riyadh-gif/solar-tracker-cps-pens/sistem_cps_tracker_pens.pdf

## Solar Tracker Dua Sumbu PENS sebagai Cyber-Physical System

Model Matematis, Validasi Numerik, dan Jalan Menuju Digital Twin

Program Magister Terapan, Politeknik Elektronika Negeri Surabaya Titik pemasangan: −7,276006◦ LS, 112,794327◦ BT

October 21, 2026

Abstract

Dokumen ini memodelkan solar tracker dua sumbu (azimuth dan kemiringan) sebagai Cyber-Physical System, mengikuti kerangka Solar Tracking Systems and Cyber-Physical Systems, tetapi dengan seluruh besaran berasal dari CAD alat, pelat nama komponen, data cuaca terukur, atau simulasi multi-benda yang tervalidasi. Setiap persamaan diberi nama modelnya dan setiap asumsi diberi tanda eksplisit.
Alat yang dimodelkan memakai motor stepper loop tertutup 57HSE1.5N (Th = 1,5 N m) dengan enkoder di poros rotor, dan reduksi gigi 5,0:1 pada sumbu kemiringan (pinion 6 gigi, gigi besar 30, modul 2,75; rasio diukur langsung di alat). Sumbu azimuth tetap penggerak langsung.
Perbedaan dengan kerangka rujukan tetap ada tetapi alasannya bergeser. Kerangka itu mengandaikan servo bertorsi dengan enkoder yang terbaca host. Di sini enkoder ada, tetapi tertutup di dalam driver: host hanya mengirim pulsa langkah dan arah, tidak pernah membaca q, dan tidak dapat memerintahkan torsi sesaat. Karena itu Computed Torque Control dan Sliding Mode Control tetap tidak dapat diterapkan apa adanya, kini karena antarmukanya, bukan karena ketiadaan sensor. Penggantinya adalah umpan maju astronomis, pembentuk perintah input shaper ZVD, dan tapis Kalman diperluas yang menaksir simpangan di sisi beban, yaitu bagian yang justru tidak terlihat oleh enkoder rotor.
Hasil utama: reduksi gigi mengubah anggaran torsi sumbu kemiringan dari 144% (macet) menjadi 24%, dan memperhalus microstep di beban dari 0,1125◦ menjadi 0,0225◦
. Karena
reduksi menaikkan pegas magnet yang dirujuk ke beban melewati kekakuan poros, frekuensi alami kemiringan hanya bergeser 4,3% terhadap seluruh rentang penguatan driver yang belum diketahui, sehingga datasheet yang masih ditunggu praktis hanya memengaruhi azimuth. Tapis Kalman dengan LDR terkalibrasi menurunkan galat pointing dari 2,52◦ menjadi 0,18◦ ;
beban angin terburuk sebelas tahun memakai 9,2% torsi tahan. Panel diparkir datar saat hujan, dan itu terbukti tidak merugikan: pada mendung tebal panel datar justru memanen 102,3% dari panel yang menjejak.

## Daftar Isi

1 Kerangka Koordinat dan Notasi | 4
2 Posisi Matahari dan Irradiance | 4

3 Kinematika | 5
4 Dinamika Multi-Benda | 6
5 Aktuator: Stepper Loop Tertutup dengan Reduksi Gigi | 8
6 Strategi Kontrol | 10
7 Model Listrik Panel Surya | 11
8 Sensor LDR dan Penggabungan Berbobot | 12
9 Beban Angin dari Data Terukur | 14

10 Hujan: Parkir Datar, Kaca Basah, dan Pendinginan | 15
11 Osilasi dan Dampaknya pada Energi | 16
12 Tapis Kalman Diperluas sebagai Penaksir Sisi Beban | 16
13 Arsitektur Cyber-Physical System | 18
14 Lapisan Digital Twin | 19
15 Ringkasan Hasil Terukur | 20
16 Kekurangan dan Parameter yang Masih Diasumsikan | 20

## 1 Kerangka Koordinat dan Notasi

Model: Kerangka toposentrik lokal North-West-Up (NWU)

Kerangka rujukan memakai ENU; dokumen ini memakai NWU karena azimuth kompas kemudian muncul langsung sebagai rotasi negatif terhadap sumbu tegak, tanpa konversi tambahan:

xˆ = Utara, | yˆ = Barat, | zˆ = atas (zenith). | (1)

Sumbu engsel kemiringan searah rel panjang, yaitu sumbu x alat, sehingga panel berguling ke kanan dan kiri, bukan jungkat-jungkit sepanjang rel.

Besaran | Lambang Definisi
Sudut sendi azimuth | q1 | putar terhadap zˆ, positif searah jarum jam dilihat dari
| atas, tanpa batas
Sudut | sendi
kemiringan
q2 | 0 = panel datar; batas ±45◦
| | (ASUMSI)
Arah hadap rel | ψ | ψ = 90◦
(rel menghadap Utara, ASUMSI)
Arah miring kompas | q1 + ψ | arah panel condong, diukur searah jarum jam dari Utara
Azimuth matahari | A | searah jarum jam dari Utara
Elevasi matahari | e | dari horizon; zenith z = 90◦ − e

## 2 Posisi Matahari dan Irradiance

### 2.1 Vektor arah matahari

Model: NREL Solar Position Algorithm (SPA), Reda dan Andreas

Kerangka rujukan memakai rumus deklinasi sederhana sin αs = sin ϕ sin δ + cos ϕ cos δ cos ω. Sistem ini memakai SPA melalui pustaka pvlib, yang memperhitungkan nutasi, aberasi, dan refraksi atmosfer. Vektor satuan menuju matahari:

sˆ =

cos e cos A
− cos e sin A
sin e

- . | (2)

Tervalidasi: selisih terhadap astropy, SolTrack, dan Pysolar di bawah 0,011◦ .

### 2.2 Irradiance langit cerah dan tutupan awan

Model: Langit cerah Ineichen-Perez; Model: Faktor awan Kasten-Czeplak; Model: Dekomposisi Erbs

Irradiance horizontal global pada tutupan awan N okta diperoleh dari nilai langit cerah:

Gh = Gh,cs "
1 − 0,75

N
8

3,4

, | N ∈ [0, 8]. | (3)

Pemisahan komponen langsung (DNI, Ib) dan baur (DHI, Id) memakai korelasi Erbs melalui indeks kecerahan kt = Gh/(I0 cos z).

### 2.3 Irradiance pada bidang panel

Model: Transposisi isotropik Liu-Jordan; Model: Koreksi sudut datang ASHRAE (Souka-Safwat)

Sudut datang θi memenuhi cos θi = sˆ · nˆ. Faktor IAM yang memodelkan pantulan kaca:

Kτ (θi) = 1 − b0

1
cos θi

− 1

, | b0 = 0,05 (ASUMSI). | (4)

Irradiance total pada bidang panel (plane of array, POA):

GPOA = Ib cos θi Kτ
| | {z | }
langsung

+ Id

1 + cos β
2
| | {z | }
baur langit

+ Gh ρg

1 − cos β
2
| | {z | }
pantulan tanah
, | (5)

dengan β kemiringan panel dari horizontal (cos β = nz) dan ρg albedo tanah (0,25 ASUMSI).

Catatan penting. Dua suku terakhir Persamaan (5) menarik titik optimum menjauh dari arah matahari, dan ke arah yang berlawanan satu sama lain. Konsekuensinya dibahas di Bagian 7.

## 3 Kinematika

### 3.1 Vektor normal panel

Model: Kinematika rotasi benda tegar, rantai dua sendi putar
Normal panel diperoleh dengan memutar vektor zenith n0 = [0, 0, 1]T berturut-turut terhadap sumbu engsel kemiringan lalu sumbu azimuth:

nˆ = Rz(−q1) Rx(q2) n0 =

sin q2 cos(q1 + ψ)
− sin q2 sin(q1 + ψ)
cos q2

- . | (6)

Basis panel yang menyertainya, dengan a = q1 + ψ dan b = q2:

xˆp =

cos b cos a
− cos b sin a
− sin b

- (arah chord, melintang engsel), yˆp =

sin a
cos a
0

- (arah span, sejajar engsel).

(7)

Tervalidasi: normal panel dari TF Gazebo berbanding Persamaan (6) pada (q1, q2) = (0, 30◦ ),
(90◦

, 30◦

), (0, −30◦

) menunjukkan selisih 0,14 sampai 0,34◦ , seluruhnya terjelaskan oleh defleksi gravitasi.

### 3.2 Kinematika balik

Untuk matahari pada (A, z) terdapat dua solusi,

(q1, q2) = (A − ψ, z) | atau | (A − ψ + 180◦
, −z), | (8)

dan dipilih cabang yang kontinu terhadap langkah sebelumnya, sehingga melewati zenith tidak menuntut putaran azimuth 180◦

### 3.3 Jacobian dan singularitas keyhole

Model: Jacobian analitik dan dekomposisi nilai singular

Turunan Persamaan (6) terhadap sudut sendi:

∂nˆ
∂q1

= − sin q2 yˆp,

∂nˆ
∂q2
= xˆp, | (9)
sehingga matriks Jacobian J = [ ∂nˆ/∂q1 | ∂nˆ/∂q2 ] ∈ R

3×2 memiliki nilai singular σ1 = 1 dan σ2 = |sin q2|, dengan bilangan kondisi

κ(J) = 1
|sin q2|
. | (10)
q2 | 1
- 5
| ◦ | 30◦ | 45◦
κ(J) 57,3 | 11,5 | 2,0 | 1,4

Inilah efek keyhole, dinyatakan sebagai hilangnya rank, bukan sebagai gejala terpisah. Dampaknya muncul kembali sebagai bobot sensor (Bagian 8) dan sebagai kovarians tapis (Bagian 12), tanpa memerlukan aturan ambang buatan.

### 3.4 Galat pointing dan rugi kosinus

Model: Hukum kosinus Lambert

θerr = arccos(nˆ · sˆ), | rugi relatif komponen langsung = 1 − cos θerr. | (11)

Untuk ayunan sinusoidal beramplitudo A0, rugi rata-rata satu siklus mendekati A²
0

/4 pada sudut
kecil.

## 4 Dinamika Multi-Benda

### 4.1 Persamaan gerak

Model: Persamaan Euler-Lagrange untuk manipulator dua derajat kebebasan

Dengan Lagrangian L = T − V dan koordinat umum q = [q1, q2]

T

, persamaan d
dt

∂L
∂q˙i

−

∂L
∂qi

= τi
menghasilkan bentuk baku manipulator:
M(q) q¨ + C(q, q˙) q˙ + g(q) + F(q˙) + τw = τ | (12)

### 4.2 Matriks massa

Model: Teorema sumbu sejajar (Steiner) atas tensor inersia CAD

Inersia efektif sumbu azimuth bergantung kemiringan:

M(q) = "
J1(q2) 0
0 J2
, J1(q2) = Iz1 +
m2r
| 2
c + Iy2
cos²
| | | q2 +Iz2 sin²
q2, | J2 = m2r

2
c +Ix2.

(13)

Bentuk ini dapat ditulis ulang sebagai J1(q2) = a + b cos² q2. Dari tensor inersia mesh CAD desain baru, dengan panel 2,55 kg menurut pelat nama:

J1(q2) = 0,1106+0,0408 cos²

q2 kg m²

, | J2 = 0,0587 kg m²
, | ∆I ≡ m2r

2

c+Iy2−Iz2 = 0,0408 kg m²
(14)
Nilai acuan: J1(0) = 0,1514 dan J1(45◦
) = 0,1310 kg m²
. Massa yang berputar pada sumbu kemiringan naik menjadi 3,782 kg (dulu 3,055) karena rangka desain baru membawa rel, braket dan empat rakitan LDR; karena itu J2 naik dari 0,0543 ke 0,0587 kg m²

Catatan reduksi gigi. Nilai di atas adalah inersia di sisi beban. Inersia rotor yang dirujuk ke beban naik N²

, dan untuk sumbu kemiringan itu 1,1×10⁻⁴ ×25 = 2,75×10⁻³ kg m² , masih dua
orde di bawah J2, jadi tidak mengubah mode lambat.

### 4.3 Suku Coriolis dan sentripetal

Model: Simbol Christoffel jenis pertama

C(q, q˙) = "
−∆I sin(2q2) ˙q2 0

1
2∆I sin(2q2) ˙q1 0
, | (15)

sehingga M˙ − 2C bersifat anti-simetris dan sistem bersifat pasif.

Status: belum diterapkan dalam simulasi. Besarnya sudah dihitung:

Keadaan | Coriolis azimuth | % torsi tahan
Jejak harian khas (q˙1 = 0,08◦/s) | 4,3 × 10⁻⁸ N m | 0,0000%
Jejak laju maksimum | 5,4 × 10⁻⁶ N m | 0,0002%
Slew 30◦/s | 9,7 × 10⁻³ N m | 0,32%
Slew 90◦/s | 8,7 × 10⁻² N m | 2,9%

Tidak berpengaruh saat menjejak, tetapi mencapai 3,4% saat slew cepat pada q2 = 45◦ .

### 4.4 Gravitasi

Model: Momen gravitasi benda tegar tak seimbang

Massa berputar pada sumbu kemiringan m2 = 3,782 kg, dengan pusat massa bergeser hanya cy = 0,23 mm dan cz = 32,82 mm dari sumbu engsel. Desain baru jauh lebih seimbang: komponen cy, yang menentukan momen pada posisi datar, turun dari 9,04 mm menjadi 0,23 mm. g(q) = "
0
−m2g (cy cos q2 − cz sin q2)
, | g = 10 m/s
| 2
(keputusan). | (16)
Posisi | Momen gravitasi | Defleksi statis
q2 = 0 (parkir) | 0,0088 N m | 0,0031◦ ; terukur Gazebo di bawah 0,001◦
q2 = −45◦ | 0,884 N m (maksimum) | 0,315◦

### 4.5 Gesekan

Model: Gesekan viskos dan Coulomb (model Coulomb-viskos)

F(q˙) = "
b1q˙1 + τc1 sgn( ˙q1)
b2q˙2 + τc2 sgn( ˙q2)
, | b = 0,2 N m s/rad, | τc = 0,05 N m. | (17)

Keduanya ASUMSI dan belum diukur. Keduanya paling menentukan lama ayunan, dan dapat diperoleh sekaligus lewat uji peluruhan bebas (Bagian 16).

### 4.6 Ruang keadaan tak linier

Model: Representasi ruang keadaan orde satu

Dengan x = [q1, q2, q˙1, q˙2]

T
:

x˙ =

"
q˙
M⁻¹
(q) [τ − C(q, q˙)q˙ − g(q) − F(q˙) − τw]
. | (18)

### 4.7 Nilai eigen dan pembuktian kestabilan

Model: Linearisasi Jacobian dan analisis nilai eigen sistem orde dua

Di sekitar titik kerja, tiap sumbu menjadi sistem orde dua dengan kekakuan efektif K (Bagian 5) dan redaman b. Dengan x = [q, q˙]

T
:

Fdyn =

∂f
∂x

=

"
0 | 1

−K/J −b/J#
, λ1,2 = −ζωn ± j ωn

q
1 − ζ
2, | (19)

dengan ωn =

p

K/J dan ζ = b/(2√
KJ).
Sumbu | Nilai eigen | Re(λ) | fn | ζ | τpeluruhan
Azimuth | −0,661 ± 44,79j | −0,661 | 7,13 Hz | 0,0147 | 1,51 s
Kemiringan | −1,704 ± 52,34j | −1,704 | 8,33 Hz | 0,0325 | 0,59 s

Bagian nyata negatif untuk kedua sumbu, sehingga sistem stabil asimtotik dan panel pasti kembali ke titik setimbang setelah bergerak. Itu pembuktian formal yang diminta.

Model: Lewatan sistem orde dua kurang teredam

Mp = exp

−πζ
p
| 1 − ζ
| 2

!
=⇒ Maz
p = 95,5%, | Mel
p = 90,3%. | (20)

Terukur di Gazebo untuk konfigurasi ini: 85,61% pada langkah azimuth 1

| | | | | ◦ , berbanding
84,65% dari model dua massa. Selisih 1,1 titik persen. Rumus analitik memberi 95,5% karena mengabaikan gesekan Coulomb dan kejenuhan torsi; model dua massa memasukkan keduanya dan Gazebo mengonfirmasinya.

Mengapa hanya langkah 1

- yang dipakai sebagai jangkar. URDF membatasi kecepatan sendi di 1 rad/s. Percepatan jenuh a = Th,L/J memberi kecepatan puncak v =

√
| | | | | 2aθ, dan langkah
azimuth 1

◦
(0,59 rad/s) adalah satu-satunya kasus yang tidak menyentuh batas itu. Pada langkah lebih besar Gazebo direm sedangkan model Python tidak punya batas itu, sehingga langkah mentah meleset makin jauh: az 5
| ◦

(1,31 rad/s) meleset 17 titik, az 90◦ (5,58 rad/s) meleset 37 titik. Sumbu kemiringan terkena batas pada semua ukuran karena percepatan jenuhnya 127,8 rad/s² ,
tiga belas kali azimuth. Seluruh strategi berprofil (trapesium, ZV, ZVD) tetap cocok dengan model dalam sekitar satu titik persen di semua kasus.

## 5 Aktuator: Stepper Loop Tertutup dengan Reduksi Gigi

Bagian ini tidak ada dalam kerangka rujukan, tetapi menentukan seluruh rancangan kontrol di sini.

### 5.1 Hukum torsi-sudut

Model: Model torsi-sudut sinusoidal motor stepper hibrid

Motor digerakkan pulsa posisi, bukan perintah torsi. Torsi pemulih bergantung selisih sudut listrik, dan pada driver loop tertutup pegas magnet diperkuat penguatan posisi driver Kp:

τ = Sat
Th sin(Nre) + Kpe, ±Th
, | e = θcmd − θrotor, | Th = 1,5 N m, | Nr = 50, | (21)

dengan Kp = 0 mengembalikan hukum loop terbuka yang lama persis.

Batas fisis yang menentukan Kp. Torsi driver tetap dibatasi Th, jadi kekakuan kecil-sinyal hanya terwujud selama |e| < Th/(ThNr +Kp). Pada Kp = 300 jangkauan linier itu 0,229◦
, sekitar
dua microstep. Limit “rotor terpaku” (Kp → ∞) tidak fisis: jangkauan liniernya nol, sehingga kekakuan yang dijanjikannya tidak pernah terwujud pada amplitudo mana pun.

### 5.2 Reduksi gigi

Model: Rantai roda gigi lurus satu tingkat

Sumbu kemiringan memakai satu tingkat reduksi; azimuth tetap penggerak langsung.

N =

z2
z1

=

30
6
= 5,0, | m = 2,75 mm, | d1 = 16,5, | d2 = 82,5 mm. | (22)

Rasio ini diukur langsung di alat (lima putaran pinion untuk satu putaran gigi besar), dan diameter luar terukur 22 dan 88 mm cocok dengan OD = m(z + 2) pada modul 2,75. Jarak sumbu 49,5 mm berbanding 50,2 mm pada CAD.

Reduksi melipatkan torsi N kali dan membagi langkah N kali:

Th,L = NTh = 7,5 N m, ∆µ,L =

∆µ
N

= 0,0225◦
. | (23)

### 5.3 Kekakuan seri

Model: Pegas seri (pegas magnet dirujuk ke beban, seri dengan poros)

Pegas magnet yang dirujuk ke sisi beban naik N²
; poros sudah berada di sisi beban sehingga tidak diskalakan:

K =

1
(ThNr + Kp)N²

+

1
k

!−1
=⇒ Kaz = 303,80, | Kel = 160,99 N m/rad, | (24)

dengan kaz = 1600 dan kel = 163,8 N m/rad. Nilai poros kemiringan itu dihitung dari panjang terukur di CAD, 194 mm untuk poros baja 8 mm, lewat k = GJ/L.

Akibat yang tidak intuitif dan penting untuk tesis ini. Pada sumbu bergigi, (ThNr + Kp)N² = 1875 N m/rad jauh melewati poros 163,8, sehingga poros yang menentukan dan penguatan driver nyaris tidak berpengaruh. Frekuensi alami kemiringan hanya bergerak dari 8,06 ke 8,41 Hz untuk Kp dari nol sampai tak hingga, yaitu sebaran 4,3%. Pada azimuth yang penggerak langsung, rentang yang sama memberi 3,46 sampai 16,36 Hz, sebaran 373%. Jadi datasheet driver yang masih ditunggu praktis hanya memengaruhi azimuth.

### 5.4 Kuantisasi microstep dan kejenuhan

Model: Kuantisasi seragam (zero-order hold spasial)

θcmd = ∆µ

$
θref
∆µ

'
, ∆µ =

1,8

◦
= 0,1125◦
. | (25)

Tangga inilah sumber eksitasi ayunan saat menjejak, bukan gangguan luar. Pada sumbu bergigi, kuantisasi yang terlihat beban menjadi ∆µ,L = 0,0225◦
, lima kali lebih
halus.

Bila torsi luar melewati Th,L motor kehilangan sinkron. Berbeda dengan desain lama, kini driver mengoreksi sendiri karena enkoder rotor melihat selisihnya; yang tersisa adalah alarm galat ikut ketika selisih melewati ambang, bukan hanyutan permanen yang diam-diam menumpuk.

Batas model. Hukum Persamaan (21) hanya bernilai tunggal bila k > Th,LNr,L. Dengan reduksi, ruas kanan menjadi 2067 N m/rad melawan poros 163,8, sehingga syarat itu gagal dan kurva torsi kuasi-statis menjadi bernilai ganda. Karena itu simulasi desain ini memakai model aktuator linier (kekakuan K dengan kejenuhan Th,L), bukan hukum sinus loop terbuka.

## 6 Strategi Kontrol

Kerangka rujukan mengusulkan Computed Torque Control, τ = M(q¨d+Kve˙+Kpe)+Cq˙+g+F, dan Sliding Mode Control dengan permukaan S = e˙ + Λe. Keduanya menuntut q dan q˙ terukur tiap siklus serta kemampuan mengatur torsi sesaat.

Alat ini kini punya enkoder, tetapi tetap tidak memenuhi syarat itu, dan alasannya bergeser. Enkoder berada di dalam driver loop tertutup: host mengirim pulsa langkah dan arah, tidak pernah membaca q, dan tidak dapat memerintahkan torsi sesaat. Lebih jauh, enkoder mengukur rotor, bukan beban, sehingga berada di sisi yang salah dari kelenturan poros dan reduksi gigi. Jadi premis “tidak ada pengukuran” kini hanya separuh benar, sedangkan premis “tidak ada antarmuka torsi” tetap berlaku penuh, dan premis kedua itu saja sudah cukup untuk menyingkirkan CTC maupun SMC.

Penggantinya tiga lapis berikut.

### 6.1 Umpan maju astronomis

Lintasan sendi dihitung dari SPA lewat kinematika balik, dibatasi |q2| ≤ 45◦ .

### 6.2 Profil gerak

Model: Profil kecepatan trapesium dengan batas percepatan

qḋes = sgn(e) min
vmax,

q
2amax|e|
, | vmax = 90◦
/s, | amax = 300◦
/s

2
, | (26)

dengan e = qref − q. Bentuk akar memastikan berhenti tepat di sasaran tanpa lewatan perintah.

### 6.3 Peredam ayunan

Model: Input shaper ZV dan ZVD (Singer dan Seering)

Deret impuls dikonvolusikan dengan perintah agar getaran sisa saling meniadakan. Dengan Ks = exp

− πζ/p
1 − ζ

2

dan jeda ∆t = Td/2 =
2fn

p
1 − ζ

2

−1
:

ZV: A =

1
1 + Ks

h
1 Ks

i
, | t =

h
0 ∆t

i
, | (27)

ZVD: A =

1
(1 + Ks)

2

h
1 2Ks K²
s

i
, | t =

h
0 ∆t 2∆t

i
. | (28)

ZVD menambah satu impuls agar tahan terhadap galat taksiran fn, dengan ongkos satu ∆t tambahan.
Hasil terukur di Gazebo, lompatan azimuth 181◦
, lima ulangan:
Strategi | Lewatan median | Lewatan terburuk
Hanya profil trapesium | 0,58% (1,05◦
| ) | 10,71% (19,35◦
)
Profil + ZVD | 0,11% (0,20◦
| ) | 1,27% (2,30◦
)

Perbandingan langkah tunggal (model Python / Gazebo):

Uji | Mentah | Trapesium | ZV | ZVD
Azimuth 90◦ | 52,43/52,41% | 0,88/0,77% 3,07/0,00% 0,26/0,00%
Azimuth 5
- 82,60/82,78% 15,46/15,77% 0,32/0,40% 0,97/0,85%

Batas penting. Input shaper tidak berguna saat menjejak pelan: satu microstep tidak dapat dipecah menjadi dua setengah langkah, sehingga setelah pembulatan perintahnya identik. Satu-satunya tuas saat menjejak adalah memperhalus ∆µ.

Sebab tambahan: pada lompatan besar pengendali jenuh di Th sehingga geraknya bang-bang, dan input shaper yang mengandaikan sistem linier sama sekali tidak berefek (terukur: lewatan 71,2% identik dengan dan tanpa ZV). Karena itu shaper harus dipasang di atas profil trapesium.

## 7 Model Listrik Panel Surya

### 7.1 Persamaan dioda tunggal

Model: Model dioda tunggal lima parameter (De Soto, Klein, Beckman); persamaan Shockley

I = IL − I0

exp

V + IRs
a
− 1
−

V + IRs

Rsh

, a =

nNskTc
q
, | (29)

dengan IL arus cahaya, I0 arus jenuh balik, Rs tahanan seri, Rsh tahanan bocor, n faktor ideal, dan Ns jumlah sel seri.

Parameter dicocokkan ke pelat nama MOS C-50-18-M dengan empat syarat: titik hubung singkat, titik rangkaian terbuka, titik daya maksimum, dan ∂P/∂V = 0 di titik daya maksimum.

Parameter | Nilai | Reproduksi STC | Model
IL | 3,0092 A | Isc | 3,000 A
I0 | 7,02 × 10⁻¹⁰ A | Voc | 22,50 V
Rs | 0,372 Ω | Imp | 2,700 A
Rsh | 121,5 Ω | Vmp | 18,50 V
n | 1,1 | Pmax | 49,95 W

Faktor ideal n tidak dapat ditentukan dari pelat nama (empat persamaan, lima anu); diperiksa bahwa n ∈ [1,0; 1,5] mengubah arus hanya 0,13%, sehingga pilihannya tidak kritis.

### 7.2 Suhu sel

Model: Model NOCT (Nominal Operating Cell Temperature)

Tc = Ta +

NOCT − 20◦C
800 W/m²
GPOA, | NOCT = 45◦C (ASUMSI). | (30)

Koefisien daya terhitung −0,497%/

◦C, wajar untuk silikon. Efisiensi modul STC 16,75%.

### 7.3 Arus sebagai sensor arah: dua batas mendasar

Pertama, memaksimalkan arus tidak mengarahkan panel ke matahari. Akibat dua suku sebaran pada Persamaan (5), puncak arus bergeser:

Albedo ρg | Pergeseran puncak | Contoh permukaan
0,10 | −2,75◦ | aspal, tanah basah
0,25 | −0,10◦ | nilai bawaan model
0,40 | +2,75◦ | beton terang, pasir

Dengan komponen langsung saja puncaknya tepat di 0

◦
. Albedo lokasi harus diukur bila arus dipakai sebagai acuan posisi.

Kedua, arus buta terhadap galat kecil. Karena Persamaan (11) bersifat kuadratik di dekat puncak, simpangan 2

- hanya mengubah arus 0,09%, jauh di bawah toleransi pabrik ±3%. Lebih jauh, perubahan arus akibat awan dua sampai tiga orde lebih besar daripada akibat salah arah:
Tutupan awan | Turun karena awan | Turun karena salah arah 5 ◦
Okta 2 | −1,0% | −0,29%
Okta 4 | −10,7% | −0,06%
Okta 6 | −40,8% | +0,96%

Pendakian bukit (perturb and observe) memakai arus berhasil saat cerah dan tenang (berhenti 0,30◦ dari puncak) tetapi tersesat sampai 51◦ ketika awan menipis 2% per detik.

## 8 Sensor LDR dan Penggabungan Berbobot

### 8.1 Model pembacaan

Model: Pembagi tegangan dengan LDR hukum pangkat, dan sekat pembayang

Hambatan LDR mengikuti hukum pangkat terhadap iluminansi, sehingga tegangan keluaran pembagi bersifat jenuh:

x =

E
L0

γ
, V = Vcc

x
1 + x
+ ν, | ν ∼ N (0, σ²
ADC), | (31)

dengan γ = 0,7 dan L0 = 20000 lux (keduanya ASUMSI). Sekat membayangi komponen langsung sebanding r tan ε dengan ε sudut miring matahari terhadap sisi LDR.

Sinyal selisih yang dipakai:

ex =

Vx+ − Vx−
Vx+ + Vx−

, ey =

Vy+ − Vy−
Vy+ + Vy−
. | (32)

Pembagian dengan jumlah membuat sinyal tahan terhadap perubahan irradiance menyeluruh.

### 8.2 Pemisahan derau dan bias

Ketidakpastian taksiran sudut adalah derau sinyal dibagi kepekaan, σq = σe/|∂e/∂q|. Diukur Monte Carlo dengan ketidakcocokan antar sensor diundi sekali per perangkat:

Langit | Derau acak q2 | Bias q2 | Derau acak q1 | Bias q1
Cerah | 0,44◦ | 2,86◦ | 0,60◦ | 4,68◦
Mendung okta 6 | 0,69◦ | 5,20◦ | 0,94◦ | 8,54◦

Yang menguasai bukan derau, melainkan bias, lima sampai sepuluh kali lebih besar. Derau dapat ditekan dengan merata-rata; bias hanya hilang dengan kalibrasi.

### 8.3 Penggabungan bobot kebalikan ragam

Model: Penaksir bobot kebalikan ragam (inverse-variance weighting, BLUE)

Untuk dua taksiran tak bias dan bebas:

xˆ =

σ

2
2xˆ1 + σ

2
1xˆ2
σ

2
1 + σ

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
. | (33)
Ketidakcocokan LDR | σq2 | σq1 | Bobot LDR q2 | Bobot LDR q1
3% (tanpa kalibrasi) | 2,92◦ | 4,08◦ | 20,9% | 11,9%
1% (kalibrasi kasar) | 1,03◦ | 1,46◦ | 67,8% | 51,4%
0,3% (kalibrasi teliti) | 0,51◦ | 0,71◦ | 89,5% | 81,8%

Bobot LDR untuk azimuth turun sendiri dari 9,2% pada q2 = 45◦ menjadi 0,5% pada q2 = 10◦ ,
karena ∂ey/∂q1 ∝ sin q2. Efek keyhole muncul kembali sebagai bobot, tanpa aturan ambang buatan.

### 8.4 Prosedur kalibrasi

Prosedur A, cahaya baur merata. Sekat hanya membayangi komponen langsung, sehingga di bawah cahaya baur murni keempat LDR menerima iluminansi sama berapa pun arah panel. Faktor koreksi dicari di ruang x = V /(Vcc − V ):

mi =

| xi
| x¯ | 1/γ
| | , | ci = 1/mi
. | (34)

Diperiksa: faktor koreksi identik sampai satu bagian per juta pada tiga pose berbeda. Di lapangan cukup menunggu mendung tebal (okta 8 menyisakan DNI hanya 2,2%).

Prosedur B, regresi sepanjang hari. Salah pasang menghasilkan e = κ δ yang ikut berubah ketika kepekaan κ berubah, sedangkan ketidakcocokan menghasilkan offset hampir tetap:

e[k] = κ[k] δ + c + ε[k]. | (35)

Kepekaan azimuth berubah 25,6 kali sepanjang hari, kemiringan hanya 1,1 kali. Hasilnya bias azimuth terpisahkan dengan baik (taksiran 1,50◦ dari sebenarnya 1,50◦
| | | | ), bias kemiringan tidak
(0,84 dari 1,00, bilangan kondisi 23936).

## 9 Beban Angin dari Data Terukur

### 9.1 Sumber dan koreksi ketinggian

Model: Reanalisis Open-Meteo (ERA5); profil pangkat Hellmann

Data: 102,984 jam reanalisis per jam untuk titik PENS, 2015 sampai 2026, lengkap dengan arah dan hembusan. Reanalisis berlaku pada 10 m; panel hanya 0,3 m di atas tanah:

v(z) = v10

z

10α
, | α = 0,30 (ASUMSI, kampus). | (36)
Pada 10 m | Di panel 0,3 m
Kecepatan rata-rata | 2,83 m/s | 0,99 m/s
Kecepatan maksimum | 9,33 m/s | 3,26 m/s
Hembusan maksimum 11 tahun | 17,81 m/s | 6,22 m/s

Arah didominasi Timur (34,3%), pola monsun. Maksimum hembusan tahunan sangat stabil (rata 16,28 m/s, simpangan baku 1,29), karena Surabaya terlalu dekat ekuator untuk siklon tropis.

### 9.2 Model torsi berarah

Model: Gaya normal pelat datar
Angin dari bearing φ berjalan menuju φ + 180◦ :

wˆ =

− cos φ, sin φ, 0

T
, | F =
1/2 ρv²A Cn (wˆ · nˆ). | (37)

Dengan pergeseran pusat tekanan ec searah chord dan es searah span, dan karena F sejajar nˆ sehingga r × F = −ecF yˆp + esF xˆp:

τel = −ecF, | τaz = −esF sin q2 | (38)

Torsi azimuth nol saat panel datar, karena gaya tegak lurus panel datar tidak dapat memu-ntir sumbu tegak. Model buta arah pada kerangka rujukan tidak memiliki sifat ini.

Tervalidasi di Gazebo: pengali 1, 2, dan 3 memberi 0,45%, 1,80%, dan 4,04% torsi tahan; rasio 4 dan 9 terbaca persis sesuai v

2
. Tanda torsi juga berbalik antara pagi dan siang karena orientasi panel berubah.

### 9.3 Margin terhadap lepas sinkron

Kasus | v di panel | % torsi tahan
Terburuk 11 tahun | 6,22 m/s | 9,2%
Pengali 1,5 | 9,33 m/s | 20,8%
Pengali 2 | 12,44 m/s | 37,0%
Pengali 3 | 18,66 m/s | 83,1%

Angin bukan risiko bagi alat ini, dengan margin sekitar sebelas kali. Preset sintetis (tenang, berangin, badai) karena itu dibuang dan diganti pengali terhadap data nyata.

## 10 Hujan: Parkir Datar, Kaca Basah, dan Pendinginan

Model: Reanalisis presipitasi Open-Meteo (ERA5)

Sumber sama dengan angin: 102,984 jam per jam untuk titik PENS, 2015 sampai 2026, kolom presipitasi, hujan dan kelembapan. Curah 1792 mm per tahun, dan pola monsun jelas: 43,7% jam siang basah pada Februari berbanding 2,2% pada Agustus. Ambang kebijakan 0,2 mm/jam dengan tahan 1 jam setelah hujan berhenti (ASUMSI, menunggu sensor hujan di alat).

### 10.1 Mengapa parkir datar tidak merugikan

Secara optik hujan adalah mendung tebal. Pada okta 8 komponen langsung runtuh ke sekitar 4 W/m²
, sehingga hampir seluruh cahaya menjadi baur. Panel datar melihat seluruh kubah langit, panel miring melihat lebih sedikit. Energi sehari pada bidang panel (7 Okt 2026, kWh/m² ):
okta | menjejak | datar | datar/menjejak
0 (cerah) | 7,70 | 7,25 | 94,1%
4 | 7,09 | 6,73 | 94,9%
6 | 5,29 | 5,20 | 98,3%
8 (hujan) | 1,77 | 1,81 | 102,3%

Jadi parkir datar saat hujan justru menang tipis, di samping membuat air mengalir keluar dan mengurangi luas hadap terhadap angin. Hanya kemiringan yang diratakan; azimuth dibiarkan di tempat karena datar berarti q2 = 0 berapa pun azimuthnya.

### 10.2 Kaca basah: lapisan air menolong, tetesan merugikan

Model: Pantulan Fresnel pada antarmuka berlapis

Ini sering disalahpahami. Lapisan air rata mengurangi pantulan, karena indeks bias air berada di antara udara dan kaca sehingga bekerja sebagai lapisan pencocok indeks:

R(n1, n2) =

n1 − n2
n1 + n2

2
, | nudara = 1,0, | nair = 1,333, | nkaca = 1,52. | (39)

Pada datang tegak: kering memantulkan 4,26%, basah 2,46%, sehingga transmisi naik 1,88%. Suku ini diturunkan, bukan ditebak.

Yang merugikan adalah tetesan yang menghamburkan dan membayangi, dan itulah satu-satunya suku empiris, 5% (ASUMSI; pustaka 2 sampai 8%). Faktor transmisi basah bersih:

Tbasah =

(1 − Rua)(1 − Rak)
1 − Ruk
(1 − ϵtetes) = 0,9679. | (40)

### 10.3 Pendinginan, dan jebakan hitung ganda

Model NOCT sudah menurunkan suhu sel saat hujan semata karena irradiance jatuh: pada udara 30◦C, POA 1000 memberi 61,2

◦C sedangkan POA 250 memberi 37,8

◦C. Pendinginan tambahan
oleh air hanya sisa 37,8 → 30◦C, yaitu sekitar 3,9% daya pada −0,497%/

◦C. Mengutip belasan
persen untuk pendinginan hujan berarti menghitung ganda efek irradiance yang sudah masuk lewat okta.

Hasil bersih pada irradiance sama (okta 8): transmisi 0,9679 dan suhu sel 37,8 → 30,0

◦C
memberi Pmp 11,265 → 11,379 W, yaitu +1,01%. Panel basah menghasilkan sedikit lebih daripada panel kering pada irradiance sama. Hujan merugikan lewat runtuhnya irradiance, bukan lewat basahnya.

Tervalidasi di Gazebo pada 18 Februari 2026 (hari siang terbasah tahun itu, 18,1 mm), okta 8: saat penanda hujan aktif, transmisi terbaca 0,9679, suhu sel 30,0

◦C, dan kemiringan parkir di 0,00◦
; saat kering, transmisi 1,0, suhu sel 33 sampai 36,5

◦C, dan panel menjejak.

## 11 Osilasi dan Dampaknya pada Energi

Ayunan diukur pada laju penuh 1000 Hz, dengan gerak jejak lambat dibuang lewat penapis lolos tinggi (rata-rata bergerak di atas 2 Hz):

Keadaan | Ayunan puncak ke puncak | Frekuensi terukur
Menjejak dekat transit zenith | az 1,90◦
| , el 0,72◦ | 5,19 dan 6,57 Hz
Setelah lompat jam besar | az 4,53◦ , el 5,44◦
Sembilan detik kemudian | 0,000◦

Frekuensi terukur 5,19 dan 6,57 Hz cocok dengan prediksi nilai eigen 4,79 dan 6,89 Hz, dan peluruhan sembilan detik sesuai konstanta waktu 1,51 s.

Penyebab rugi energi | Besarnya
Suhu sel 55◦C dibanding 25◦C | 14,9%
Toleransi pabrik panel | 3,0%
Defleksi gravitasi 0,72◦ | 0,008%
Ayunan motor saat menjejak | 0,007%

Osilasi hampir tidak merugikan energi, dua ribu kali lebih kecil daripada pengaruh suhu. Dampak harian lompatan besar lima kali sehari hanya 0,19 mWh dari panen 431 Wh. Peredam ZVD tetap diperlukan, tetapi alasannya beban mekanik, risiko lepas sinkron, dan derau ke sensor, bukan panen energi.

## 12 Tapis Kalman Diperluas sebagai Penaksir Sisi Beban

### 12.1 Keadaan yang ditaksir

Kerangka rujukan mengusulkan UKF menaksir parameter fisis θ = [m2, rc, b1, b2, Cm,A, Cm,E]. Enkoder driver sudah menutup loop di sisi rotor, sehingga lepas langkah terkumpul bukan lagi masalah. Yang tersisa, dan justru tidak terlihat enkoder, adalah segala sesuatu di seberang gigi dan poros: puntiran poros, backlash gigi, salah pasang mekanik, dan bias LDR. Karena itu yang ditaksir adalah simpangan antara perintah dan beban:

b =

"
baz

bel#
= qbeban − qperintah, | (41)

yang memuat salah pasang mekanik, lepas langkah terkumpul, dan sisa defleksi.

### 12.2 Persamaan tapis

Model: Extended Kalman Filter, bentuk kovarians Joseph

Model proses jalan acak (F = I) karena lepas langkah tidak dapat diramalkan:

Prediksi: ˆb

− = ˆb, | P
− = P + Q ∆t, | (42)

Inovasi: y = z − h(

ˆb

−), H =

∂h
∂b

ˆb⁻

, | S = HP ⁻HT + R, | (43)

Penguatan: K = P

−HTS

−1
,

ˆb = ˆb

− + Ky, | (44)

Kovarians: P = (I − KH)P

−(I − KH)
T + KRKT
. | (45)

Bentuk Joseph dipakai agar P tetap simetris dan definit positif.

Fungsi pengukuran h adalah model LDR Persamaan (32), sehingga H mengandung Jacobian kinematik; itulah pertemuan antara singularitas keyhole dan kovarians tapis.

Model: Uji pencilan khi-kuadrat atas inovasi ternormalkan (NIS)

ϵ = y

TS

−1y ∼ χ
2
m, | pengukuran ditolak bila ϵ > ϵmax = 25. | (46)

### 12.3 Hasil terukur

Hari 7 Oktober 2026, lepas langkah azimuth 7,2

- disuntikkan di tengah hari; galat diukur hanya saat matahari terjangkau:
Susunan | Galat rata-rata | p95
Astro saja, tanpa tapis | 2,52◦ | 5,30◦
EKF + LDR terkalibrasi | 0,18◦ | 0,39◦
EKF + LDR 3% tidak terkalibrasi | 5,63◦ | 6,10◦
EKF + LDR terkalibrasi + arus | 0,18◦ | 0,39◦
EKF + arus saja | 2,24◦ | 5,17◦

Tapis pulih dari lepas langkah 7,2

- dalam sekitar 350 detik tanpa pernah diberi tahu bahwa lepas langkah terjadi.

Tiga kesimpulan. (i) LDR terkalibrasi memperbaiki empat belas kali. (ii) LDR tidak terkalibrasi lebih buruk daripada tidak memakai LDR sama sekali: bias LDR tidak dapat dibedakan dari salah pasang mekanik (tidak teramati secara terpisah), sehingga tapis menyerap-nya lalu mengarahkan panel keliru. (iii) Arus hampir tidak menambah apa pun, sesuai ∂I/∂b ≈ 0 di dekat puncak.

### 12.4 Keyhole sebagai kovarians

Keadaan | ∂ey/∂baz | σaz dilaporkan
Matahari elevasi 45◦ | 0,00091 | 0,67◦
Matahari elevasi 85◦ | 0,00019 | 2,65◦

### 12.5 Dua pengaman yang wajib

Keduanya ditemukan ketika loop tertutup menyimpang di Gazebo.

1. LDR hanya dipakai saat matahari terjangkau. Bila zenith melewati 45◦
, kemiringan
terpotong dan LDR membaca galat besar yang bukan berasal dari simpangan sendi.

2. Anti-penyimpangan pada gerbang pencilan. Bila taksiran telanjur salah, inovasi mem-besar, gerbang menolak semua pengukuran, dan tapis terkunci selamanya (terukur: NIS tetap 82 sampai 90, taksiran macet di −6,47◦
). Setelah sepuluh penolakan beruntun, P digem-bungkan.

### 12.6 Pelajaran tentang matriks kovarians pengukuran

Matriks R untuk pengukuran arus wajib memuat galat model, bukan hanya derau sensor:

RI = σ

2
ADC +
κmodel Î

2
, | κmodel = 0,03. | (47)

Mengisinya dengan derau ADC 0,2 mA saja membuat K = PHTS

| −1 | ribuan kali terlalu besar,
dan galat pointing melonjak dari 0,18◦ menjadi 20,5
| ◦ .

### 12.7 Kejujuran tapis

Tapis masih terlalu percaya diri sekitar 3,4 kali pada azimuth: σ dilaporkan 0,23◦
| | sedangkan
sebaran galat sebenarnya 0,79◦
. Sebabnya Q berbentuk jalan acak halus sedangkan lepas langkah datang sebagai lompatan.

## 13 Arsitektur Cyber-Physical System

+--------------------------------------------------------------------+
| | | LAPISAN CYBER | | | |
| sun_command_node | --> | profil trapesium + ZVD | <-- | ekf_node | |
| (pvlib SPA, IK) | (100 Hz) | (taksir b, P) |
| sensor_node | --> /tracker/diag (5 Hz), /ldr/state | ^ | |
| wind_node | --> angin nyata berarah (Open-Meteo) | | | |
+-----------------------------+------------------------------+------+
| perintah posisi (rad) | |
+-----------------------------v------------------------------+------+
| LAPISAN ANTARMUKA : ros_gz_bridge | |
| | kuantisasi microstep 0,1125 deg | <-- Q(.) | |
| | kejenuhan torsi 3 N m | <-- Sat(.) | |
+-----------------------------+------------------------------+------+
| tau(t) | /joint_states (1 kHz) |
+-----------------------------v------------------------------+------+
| LAPISAN FISIK : Gazebo DART, langkah 1 ms | |
| | M(q) qdd + C(q,qd) qd + g(q) + F(qd) + tau_w = tau | |
| | gangguan: angin berarah, defleksi gravitasi, lepas langkah | |
+--------------------------------------------------------------------+
Kerangka rujukan | Di sistem ini | Status
Plant dinamika kontinu | Gazebo DART, langkah 1 ms | berjalan
Kuantisasi Q(·) | pembulatan microstep 0,1125◦ | berjalan
Kejenuhan Sat(·) | batas torsi 3 N m | berjalan
Algoritma orbit astronomis | pvlib SPA | tervalidasi 0,011◦
Pengendali diskret | node ROS 2, 100 Hz | berjalan
Penaksir keadaan (EKF) | ekf_node | berjalan

Kerangka rujukan | Di sistem ini | Status
Enkoder kuadratur | ada, di rotor, tertutup di dalam
driver

tidak terbaca host; sisi
beban | tetap | ditaksir
EKF
Latensi jaringan, jitter | belum dimodelkan | kekurangan
Serangan FDI, NTP poisoning | belum dimodelkan | kekurangan
Event-triggered control | belum ada | kekurangan

Catatan tentang jam. Seluruh node memakai use_sim_time. Tanpa itu, profil gerak dan input shaper berjalan pada jam dinding sedangkan plant pada jam simulasi (Gazebo sekitar 85% real-time), sehingga lewatan menjadi tidak dapat diulang: terukur 7,6% sampai 0,35% pada uji yang sama.

### 13.1 Model keadaan hibrid

Model: Sistem sampled-data dengan tundaan dan kuantisasi

Kerangka rujukan menuliskan bentuk hibrid yang relevan dan belum diterapkan di sini:

y˜[k] = Q

x(kTs − τd,s)
+ v[k], | (48)

uc[k] = C

y˜[k], qd[k], θˆ[k]
, | (49)
τ (t) = Sat
uc[k − da] + ak
, | t ∈ [kTs + τd, (k + 1)Ts + τd), | (50)

dengan da kehilangan paket, τd tundaan total, dan ak penyuntikan data palsu. Kuantisasi Q dan kejenuhan Sat sudah ada; τd,s, da, dan ak belum.

## 14 Lapisan Digital Twin

Model: Taksonomi Kritzinger

Tingkat | Aliran data | Posisi
Digital Model | tidak ada, manual | di sini
Digital Shadow | otomatis, fisik → digital | belum
Digital Twin | otomatis, dua arah | belum

Yang ada adalah Digital Model tervalidasi silang tiga jalur: nilai eigen analitik, model Python dua sumbu, dan Gazebo saling cocok. Yang belum ada adalah hubungan ke alat fisik.

Jembatannya pendek. Node sensor_node menghasilkan data sensor dan menerbitkannya ke /tracker/diag; ekf_node memakannya dari topik itu. Mengganti sensor_node dengan node pembaca perangkat keras yang menerbitkan pesan sama membuat seluruh rantai di belakangnya berjalan tanpa perubahan.

Usulan kerangka rujukan yang belum ada: identifikasi parameter θ secara daring, optimasi multi-objektif prediktif max P
k

[w1Pgen −w2Pact −w3Dfatigue], indeks kesehatan dari hanyutan gesekan, dan deteksi backlash. Dua usulan lain tidak berlaku: intelligent backtracking ditujukan untuk ladang surya banyak panel (alat ini satu panel), dan predictive aero-elastic wind stow tidak mendesak karena margin angin sebelas kali.

Catatan untuk pekerjaan lanjut. Biaya kelelahan struktur Dfatigue = ∥τ (k) − τ (k − 1)∥

2
memberi pembenaran kuantitatif bagi peredam ZVD, yang selama ini hanya dapat dibenarkan secara kualitatif karena rugi energinya 0,007%.

## 15 Ringkasan Hasil Terukur

Besaran | Nilai | Cara diperoleh
Posisi matahari | selisih < 0,011◦ | SPA | vs | astropy,
SolTrack, Pysolar
Kinematika normal panel | selisih 0,14–0,34◦ | Gazebo TF vs Pers. (6)
Defleksi gravitasi q2 = 0 | 0,161◦ vs 0,155◦ | Gazebo vs Pers. (16)
Frekuensi alami azimuth | 4,79 prediksi, 5,19 terukur Hz

nilai eigen vs Gazebo 1
| | kHz
Lewatan langkah 1
- | 93,3% teori, 90% terukur | analitik vs Gazebo
ZVD menekan lewatan terburuk | 19,35◦ → 2,30◦ | Gazebo, lima ulangan
Rugi energi dari osilasi | 0,007% | model dua sumbu 1 kHz
Energi harian 7 Okt | 431,0 Wh vs 362,3 Wh datar
model dioda tunggal
Margin angin terburuk 11 tahun | 9,2% torsi tahan | Open-Meteo | +
Pers. (38)
EKF dengan LDR terkalibrasi | 2,52◦ → 0,18◦
simulasi hari penuh
Pemulihan lepas langkah 7,2
- | 350 detik | simulasi hari penuh

## 16 Kekurangan dan Parameter yang Masih Diasumsikan

Belum dimodelkan: suku Coriolis (besarnya sudah dihitung, 3,4% saat slew), latensi dan jitter jaringan, serangan siber, event-triggered control, optimasi multi-objektif, backlash kopling, dan mode getar rangka.

Asumsi yang paling menentukan:

Parameter | Nilai | Cara mengukur
Redaman sendi b | 0,2 N m s/rad | uji peluruhan bebas
Gesekan Coulomb τc | 0,05 N m | torsi minimum penggerak
Kekakuan poros k | 317 | dan | 1600
N m/rad

uji peluruhan bebas

Eksponen LDR γ | 0,7 | kurva lux-tegangan di meja
Setengah jenuh L0 | 20000 lux | kurva yang sama
Ketidakcocokan LDR | 3% | prosedur A saat mendung
Batas kemiringan | 45◦ | gerakkan sampai menumbuk
Arah hadap rel ψ | 90◦ | kompas
Massa motor | 1,2 kg | timbang atau lembar data
Koefisien angin Cn | 1,2 | tabel beban angin atau CFD
Pusat tekanan ec, es | 0,0668, 0,02 m | aerodinamika pelat datar

Uji peluruhan bebas adalah percobaan tunggal paling bernilai: dari satu rekaman langkah dapat diperoleh ωn (dari frekuensi ayunan), ζ lalu b (dari rasio puncak berurutan melalui ζ = − ln(rasio)/2π), dan τc (dari simpangan sisa yang tidak kembali ke nol).

Dua klaim yang ditarik dalam pengerjaan: batas angin tarik-lepas 9,6 m/s (lengan momen tebakan; rentang sebenarnya 6,5 sampai 39 m/s) dan pergeseran puncak arus +2,6

◦
(irradiance
pilihan tangan tidak konsisten dengan Gh = Ib sin e + Id).

## Rujukan Model

[1] I. Reda dan A. Andreas, Solar Position Algorithm for Solar Radiation Applications, NREL/TP-560-34302. Dipakai lewat pvlib.
[2] P. Ineichen dan R. Perez, A new airmass independent formulation for the Linke turbidity coefficient, Solar Energy, 2002.
[3] F. Kasten dan G. Czeplak, Solar and terrestrial radiation dependent on the amount and type of cloud, Solar Energy, 1980.
[4] D. G. Erbs, S. A. Klein, dan J. A. Duffie, Estimation of the diffuse radiation fraction, Solar Energy, 1982.
[5] B. Y. H. Liu dan R. C. Jordan, model transposisi isotropik untuk irradiance bidang miring.
[6] ASHRAE, model incidence angle modifier; lihat juga Souka dan Safwat.
[7] W. De Soto, S. A. Klein, dan W. A. Beckman, Improvement and validation of a model for photovoltaic array performance, Solar Energy, 2006.
[8] N. C. Singer dan W. P. Seering, Preshaping command inputs to reduce system vibration, ASME J. Dynamic Systems, Measurement and Control, 1990.
[9] M. W. Spong, S. Hutchinson, dan M. Vidyasagar, Robot Modeling and Control (persamaan manipulator dan simbol Christoffel).
[10] Y. Bar-Shalom, X. R. Li, dan T. Kirubarajan, Estimation with Applications to Tracking and Naviga-tion (EKF, bentuk Joseph, uji NIS).
[11] W. Kritzinger dkk., Digital Twin in manufacturing: A categorical literature review and classification, IFAC-PapersOnLine, 2018.
[12] Open-Meteo Historical Weather API, reanalisis ERA5 per jam.
