riyadh-gif/solar-tracker-cps-pens/desainbaru/WhatsApp Image 2026-10-19 at 14.08.28.jpeg

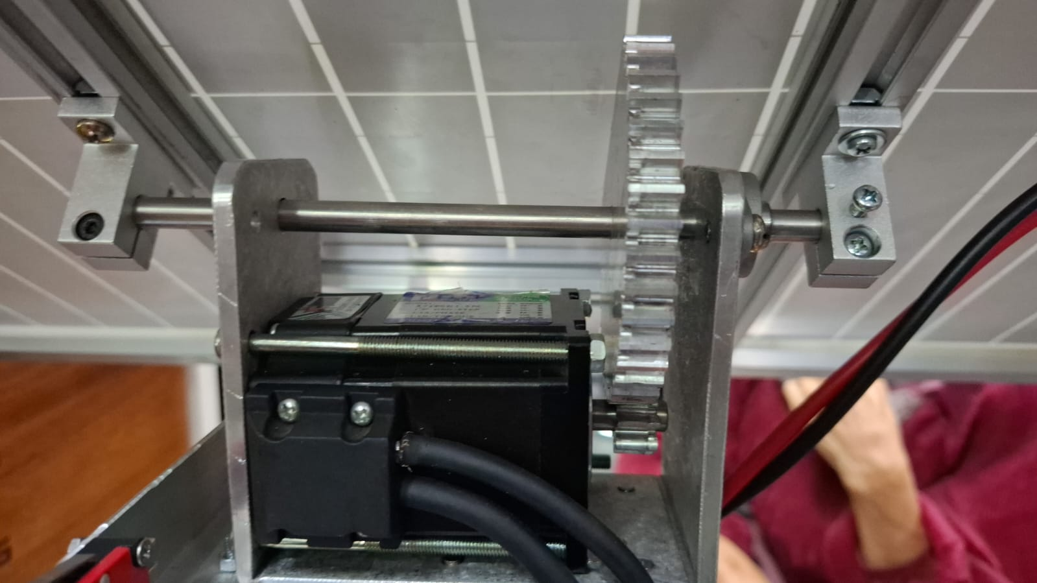
desainbaru/WhatsApp Image 2026-10-19 at 14.08.28.jpeg
