riyadh-gif/solar-tracker-cps-pens/desainbaru/WhatsApp Image 2026-10-19 at 14.28.11.jpeg

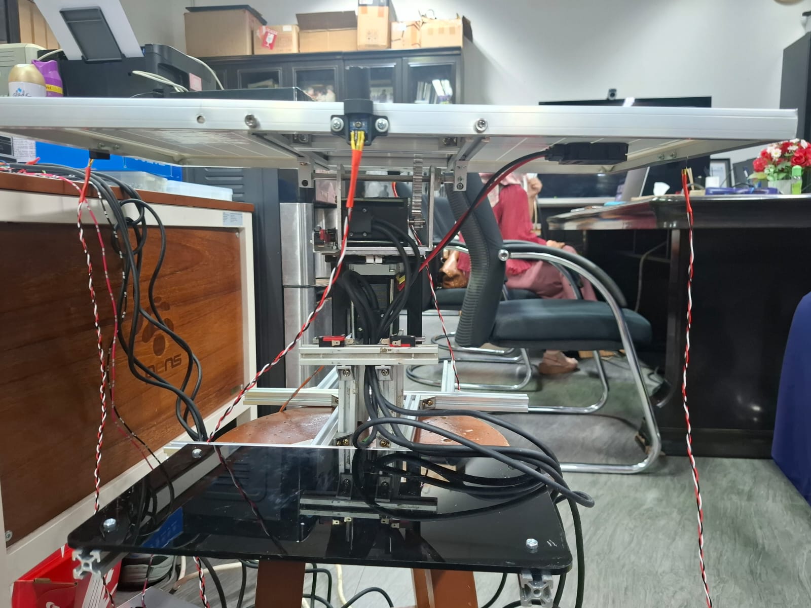
desainbaru/WhatsApp Image 2026-10-19 at 14.28.11.jpeg
