riyadh-gif/solar-tracker-cps-pens/New folder (2)/solar.stp

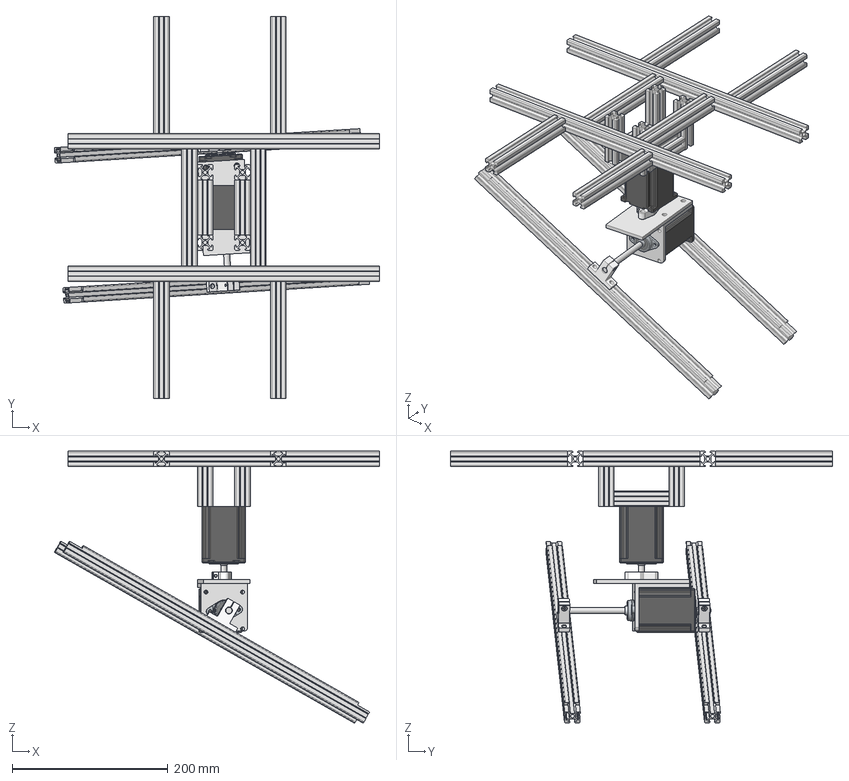
[picture p6: CAD file, 2026-10-19]
New folder (2)/solar.stp
417.5 x 490.0 x 348.7 mm
ALUMUNIUM PROFILE 2020 1000 x 2
ALUMUNIUM PROFILE 2020 500 x 6
ALUMUNIUM PROFILE 2020443 x 2
57HSE 3.0N_1 x 2
SK8 Linear Shaft Support v1 x 2
as 8mm
pangkon stepper3
KFL08
alas
SHF8 Shaft support
ALUMUNIUM PROFILE 2020 70 x 6
