riyadh-gif/solar-tracker-cps-pens/New folder (2)/solar_stl/parts_v2/00_part.stl

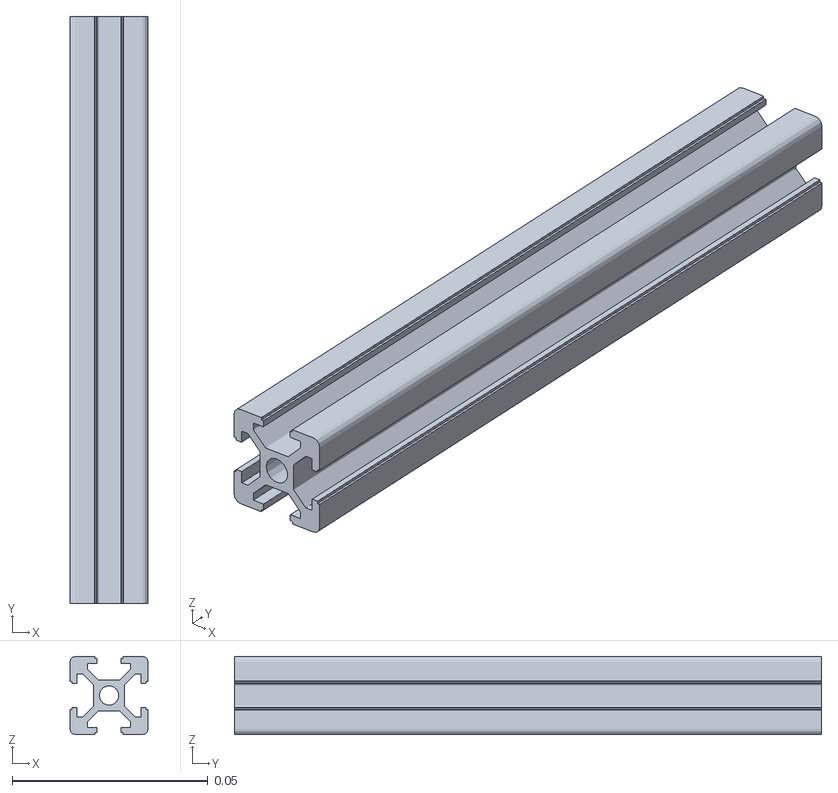
[picture p7: CAD file, 2026-10-19]
New folder (2)/solar_stl/parts_v2/00_part.stl
0.02 x 0.15 x 0.02
