riyadh-gif/solar-tracker-cps-pens/New folder (2)/solar_stl/parts_v2/05_part.stl

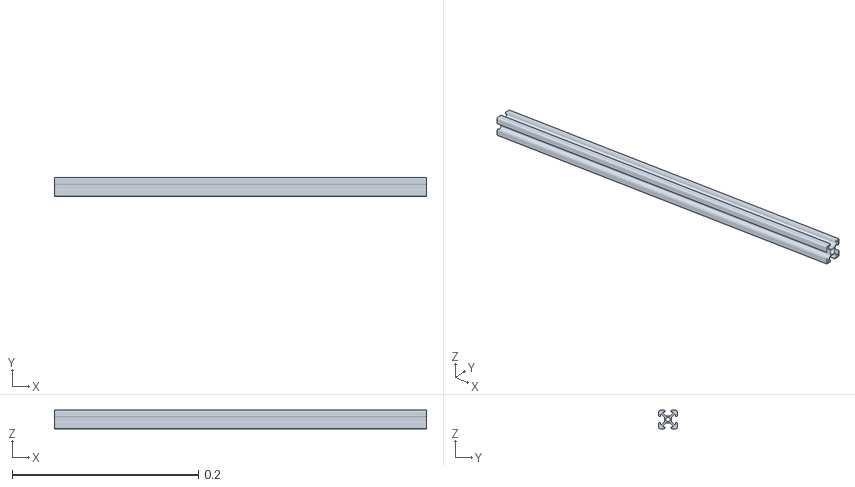
[picture p8: CAD file, 2026-10-19]
New folder (2)/solar_stl/parts_v2/05_part.stl
0.4 x 0.02 x 0.02
