riyadh-gif/solar-tracker-cps-pens/New folder (2)/solar_stl/parts_v2/21_part.stl

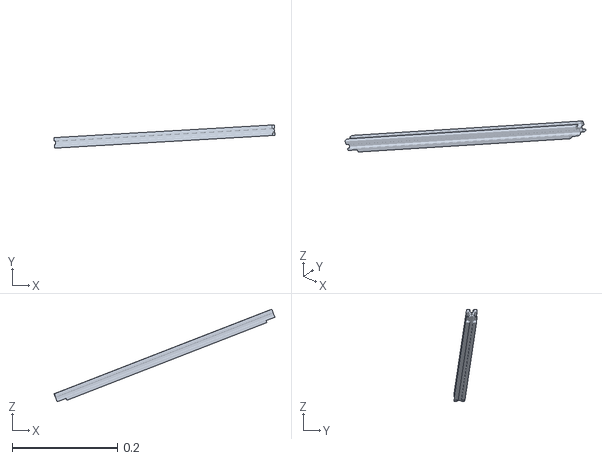
[picture p9: CAD file, 2026-10-19]
New folder (2)/solar_stl/parts_v2/21_part.stl
0.419 x 0.0442 x 0.175
