riyadh-gif/solar-tracker-cps-pens/New folder (2)/solar_stl/parts_v2/17_part.stl

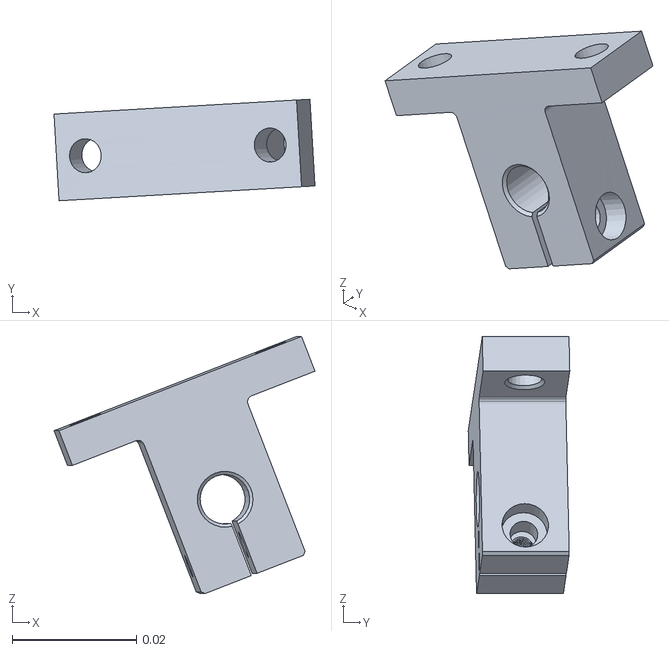
[picture p10: CAD file, 2026-10-19]
New folder (2)/solar_stl/parts_v2/17_part.stl
0.0421 x 0.0164 x 0.0414
