riyadh-gif/solar-tracker-cps-pens/New folder (2)/solar_stl/parts_v2/19_part.stl

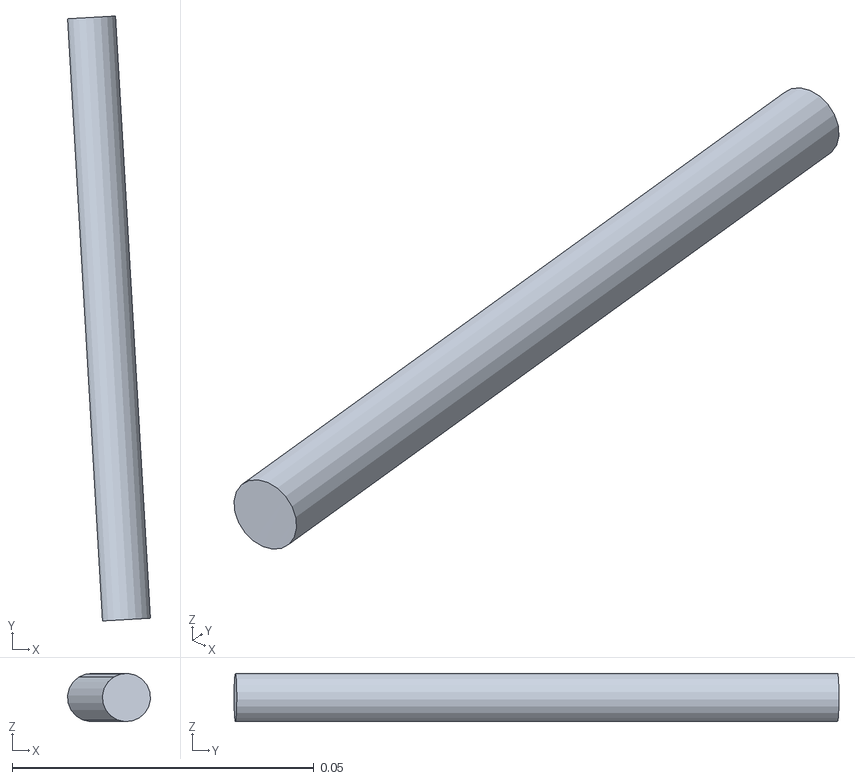
[picture p11: CAD file, 2026-10-19]
New folder (2)/solar_stl/parts_v2/19_part.stl
0.0138 x 0.1 x 0.00798
