riyadh-gif/solar-tracker-cps-pens/New folder (2)/solar_stl/parts_v2/09_part.stl

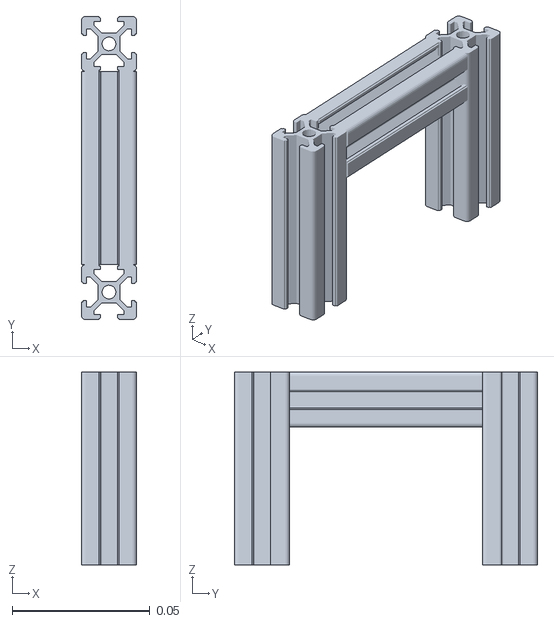
[picture p12: CAD file, 2026-10-19]
New folder (2)/solar_stl/parts_v2/09_part.stl
0.02 x 0.11 x 0.07
