riyadh-gif/solar-tracker-cps-pens/New folder (2)/solar_stl/parts_v2/12_part.stl

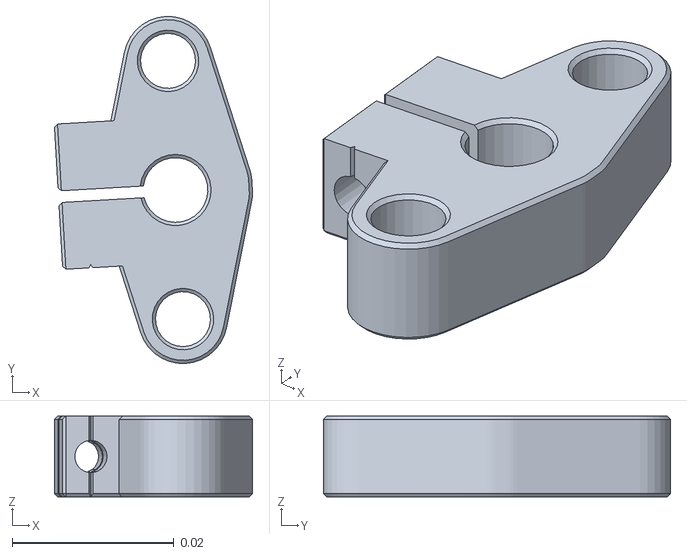
[picture p13: CAD file, 2026-10-19]
New folder (2)/solar_stl/parts_v2/12_part.stl
0.0245 x 0.0429 x 0.01
