riyadh-gif/solar-tracker-cps-pens/New folder (2)/solar_stl/parts_v2/11_part.stl

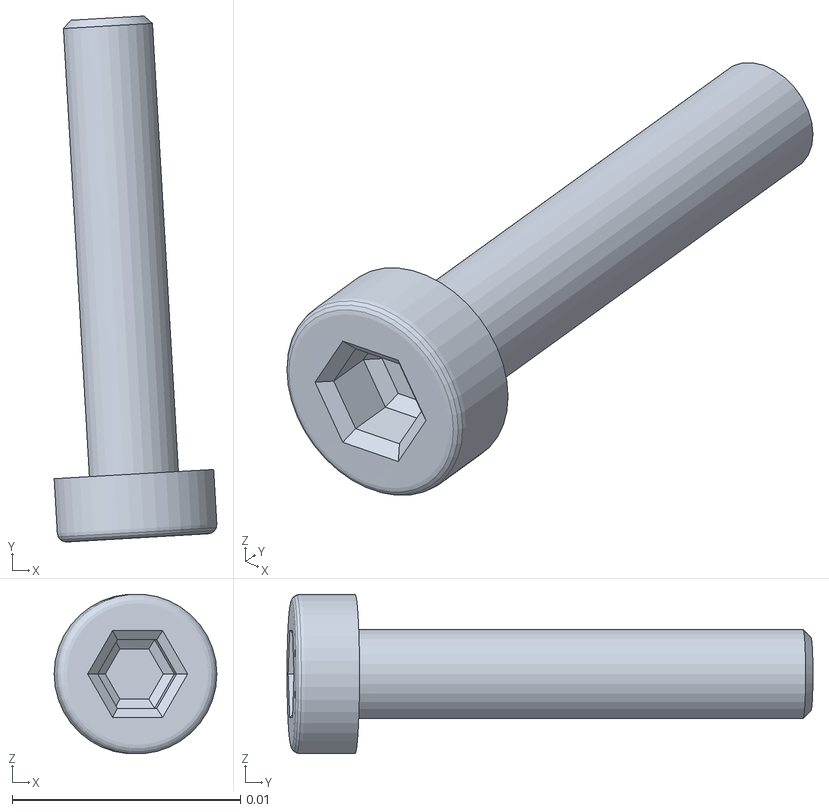
[picture p14: CAD file, 2026-10-19]
New folder (2)/solar_stl/parts_v2/11_part.stl
0.00713 x 0.023 x 0.00698
