riyadh-gif/solar-tracker-cps-pens/New folder (2)/solar_stl/parts_v2/13_part.stl

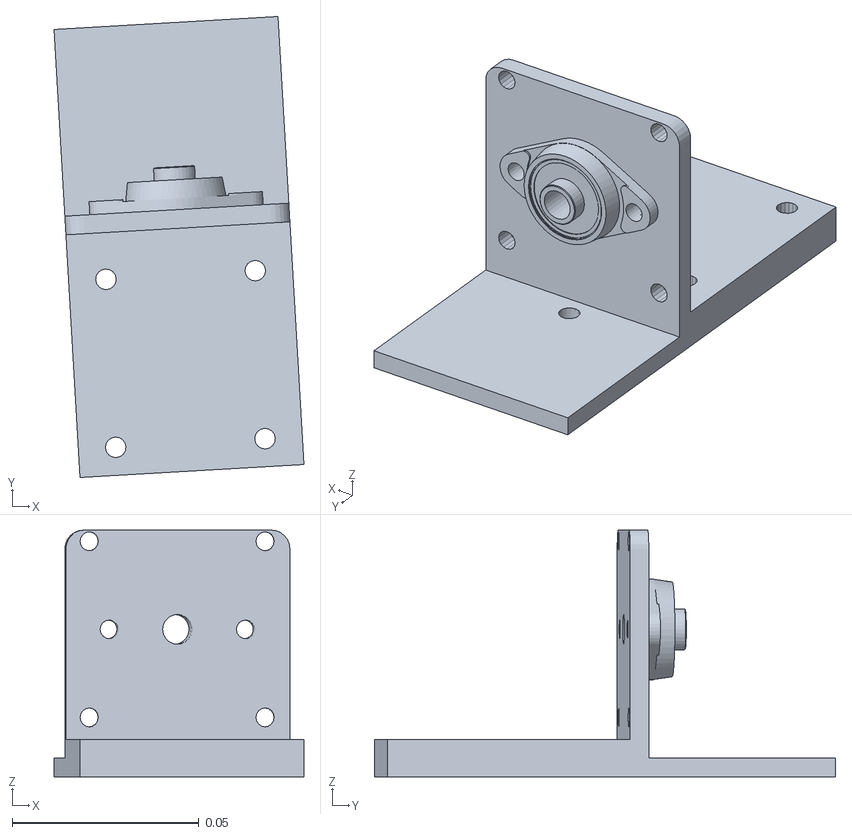
[picture p15: CAD file, 2026-10-19]
New folder (2)/solar_stl/parts_v2/13_part.stl
0.0668 x 0.123 x 0.066
