riyadh-gif/solar-tracker-cps-pens/New folder (2)/solar_stl/parts_v2/14_part.stl

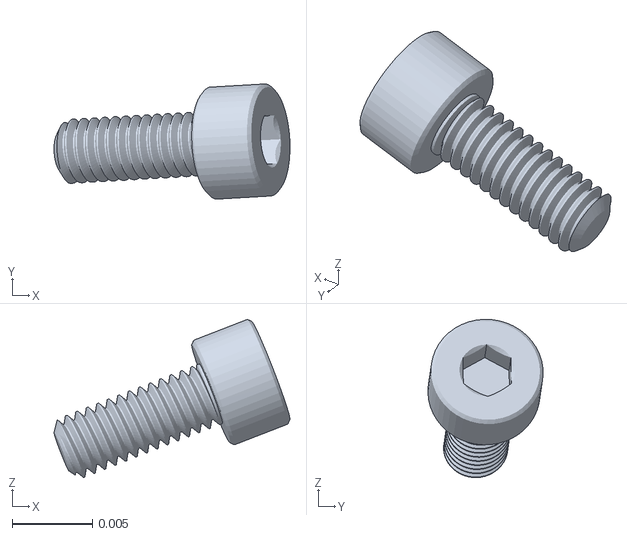
[picture p16: CAD file, 2026-10-19]
New folder (2)/solar_stl/parts_v2/14_part.stl
0.0147 x 0.00718 x 0.00986
