riyadh-gif/solar-tracker-cps-pens/New folder (2)/solar_stl/parts_v2/18_part.stl

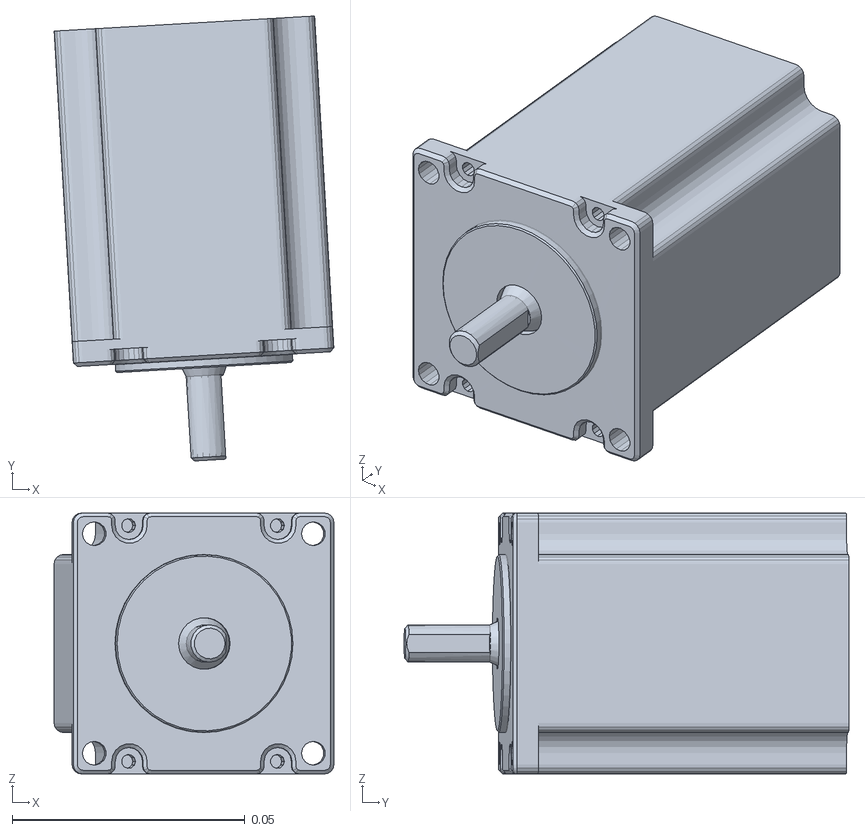
[picture p17: CAD file, 2026-10-19]
New folder (2)/solar_stl/parts_v2/18_part.stl
0.06 x 0.0955 x 0.056
