riyadh-gif/solar-tracker-cps-pens/New folder (2)/solar_stl/parts_v2/10_part.stl

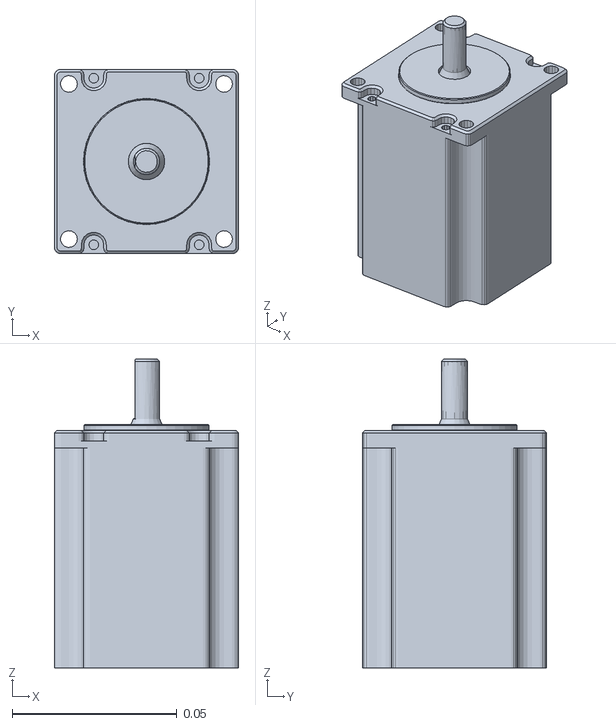
[picture p18: CAD file, 2026-10-19]
New folder (2)/solar_stl/parts_v2/10_part.stl
0.056 x 0.056 x 0.0938
