riyadh-gif/solar-tracker-cps-pens/(list of files, cad)

Other CAD files:
New folder (2)/solar_stl/parts_v2/04_part.stl
New folder (2)/solar_stl/parts_v2/01_part.stl
New folder (2)/solar_stl/parts_v2/07_part.stl
New folder (2)/solar_stl/parts_v2/03_part.stl
New folder (2)/solar_stl/parts_v2/06_part.stl
New folder (2)/solar_stl/parts_v2/20_part.stl
New folder (2)/solar_stl/parts_v2/16_part.stl
New folder (2)/solar_stl/parts_v2/02_part.stl
New folder (2)/solar_stl/parts_v2/08_part.stl
New folder (2)/solar_stl/parts_v2/15_part.stl
