riyadh-gif/solar-tracker-cps-pens/gabungan/stow_results_tables.md

# Tabel hasil strategi parkir dan acuan rumah (dibuat otomatis oleh stow_sim.py)

2026-10-04, langit cerah, astronomi saja (sensor tidak berpengaruh pada energi), 20 seed angin per sel. stow = ambang parkir (m/s, 0 = tanpa parkir). acuan = ada saklar posisi rumah. p_event = fraksi hari dengan minimal satu kejadian melewati torsi tahan, n_event = rata-rata kejadian per hari, lost_h = jam panel tidak berguna, energi_pct = energi harian terhadap pelacakan ideal tanpa angin pada k_flat yang sama (sumbu hilang dianggap energi nol), stow_frac = fraksi waktu terparkir.

## k_flat = 1.0 (momen angin saat panel datar = 1.0 x momen saat miring 45 deg)

| vm | stow | acuan | vrec | p_event | n_event | lost_h | energi_pct | stow_frac | vmax |
|---|---|---|---|---|---|---|---|---|---|
| 3 | 0 | False | 0 | 0 | 0 | 0 | 100 | 0 | 8.84 |
| 3 | 0 | True | 8 | 0 | 0 | 0 | 100 | 0 | 8.84 |
| 3 | 0 | True | 10 | 0 | 0 | 0 | 100 | 0 | 8.84 |
| 3 | 0 | True | 12 | 0 | 0 | 0 | 100 | 0 | 8.84 |
| 3 | 8 | False | 0 | 0 | 0 | 0 | 100 | 0.00122 | 8.84 |
| 3 | 8 | True | 8 | 0 | 0 | 0 | 100 | 0.00122 | 8.84 |
| 3 | 8 | True | 10 | 0 | 0 | 0 | 100 | 0.00122 | 8.84 |
| 3 | 8 | True | 12 | 0 | 0 | 0 | 100 | 0.00122 | 8.84 |
| 3 | 10 | False | 0 | 0 | 0 | 0 | 100 | 0 | 8.84 |
| 3 | 10 | True | 8 | 0 | 0 | 0 | 100 | 0 | 8.84 |
| 3 | 10 | True | 10 | 0 | 0 | 0 | 100 | 0 | 8.84 |
| 3 | 10 | True | 12 | 0 | 0 | 0 | 100 | 0 | 8.84 |
| 3 | 12 | False | 0 | 0 | 0 | 0 | 100 | 0 | 8.84 |
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
| 9 | 12 | 1 | 0.85 | 2.1 | 40 | 0.998 |
| 9 | 12 | 3 | 0.85 | 2.1 | 40 | 0.998 |
| 9 | 12 | 10 | 0.85 | 2.1 | 40 | 0.998 |
| 9 | 15 | 1 | 0.9 | 2.4 | 30.1 | 0.984 |
| 9 | 15 | 3 | 0.85 | 2.35 | 34.3 | 0.984 |
| 9 | 15 | 10 | 0.85 | 2.25 | 36.9 | 0.984 |
