riyadh-gif/solar-tracker-cps-pens/kontrol_hibrid/hybrid_results_tables.md

# Tabel hasil simulasi kontrol hibrid (dibuat otomatis oleh hybrid_sim.py)

Rata-rata antar seed (cerah 1 seed, sebagian 4, mendung 2). Galat = sudut antara normal panel dan matahari, hanya saat matahari terjangkau (zenith <= 45 deg).
acts = jumlah perubahan microstep (dua sumbu), gain = energi bidang vs panel tetap miring 7 deg utara, f_ldr = fraksi waktu LDR dipakai.

## E1: 2026-10-04

| weather | bias | ctrl | rmse | tae | p95 | acts | gain | f_ldr |
|---|---|---|---|---|---|---|---|---|
| cerah | 0/0 | astro | 0.0363 | 0.0326 | 0.0603 | 2.29e+03 | 19.5 | 0 |
| cerah | 0/0 | ldr | 4.47 | 4.46 | 4.79 | 709 | 19.3 | 1 |
| cerah | 0/0 | saputra | 4.4 | 4.37 | 4.88 | 928 | 19.3 | 0.815 |
| cerah | 0/0 | bias | 3.69 | 3.62 | 4.51 | 2.29e+03 | 19.4 | 0.773 |
| cerah | 3/2 | astro | 2.4 | 2.38 | 2.88 | 2.29e+03 | 19.6 | 0 |
| cerah | 3/2 | ldr | 4.48 | 4.48 | 4.79 | 690 | 19.3 | 1 |
| cerah | 3/2 | saputra | 4.31 | 4.25 | 4.86 | 1.33e+03 | 19.5 | 0.817 |
| cerah | 3/2 | bias | 3.85 | 3.78 | 4.61 | 2.33e+03 | 19.5 | 0.78 |
| cerah | 6/4 | astro | 4.84 | 4.8 | 5.81 | 2.29e+03 | 19.6 | 0 |
| cerah | 6/4 | ldr | 4.51 | 4.5 | 4.81 | 692 | 19.2 | 1 |
| cerah | 6/4 | saputra | 4.23 | 4.16 | 4.83 | 1.5e+03 | 19.6 | 0.818 |
| cerah | 6/4 | bias | 3.93 | 3.88 | 4.61 | 2.36e+03 | 19.7 | 0.784 |
| sebagian | 0/0 | astro | 0.0363 | 0.0326 | 0.0603 | 2.29e+03 | 14.9 | 0 |
| sebagian | 0/0 | ldr | 17.6 | 12 | 39.9 | 7.92e+03 | 13.6 | 1 |
| sebagian | 0/0 | saputra | 3.78 | 2.42 | 5.49 | 2.75e+03 | 14.8 | 0.53 |
| sebagian | 0/0 | bias | 2.93 | 2.84 | 3.73 | 2.35e+03 | 14.9 | 0.457 |
| sebagian | 3/2 | astro | 2.4 | 2.38 | 2.88 | 2.29e+03 | 14.9 | 0 |
| sebagian | 3/2 | ldr | 17.5 | 12.1 | 39.2 | 7.69e+03 | 13.4 | 1 |
| sebagian | 3/2 | saputra | 4.41 | 3.22 | 5.71 | 2.96e+03 | 14.9 | 0.531 |
| sebagian | 3/2 | bias | 2.71 | 2.63 | 3.52 | 2.35e+03 | 15 | 0.462 |
| sebagian | 6/4 | astro | 4.84 | 4.8 | 5.81 | 2.29e+03 | 14.7 | 0 |
| sebagian | 6/4 | ldr | 17.2 | 11.8 | 38.7 | 7.99e+03 | 13.6 | 1 |
| sebagian | 6/4 | saputra | 5.25 | 4.08 | 7.06 | 3.21e+03 | 14.9 | 0.531 |
| sebagian | 6/4 | bias | 2.27 | 2.24 | 2.79 | 2.35e+03 | 15.1 | 0.466 |
| mendung | 0/0 | astro | 0.0363 | 0.0326 | 0.0603 | 2.29e+03 | -4.5 | 0 |
| mendung | 0/0 | ldr | 34.2 | 32.4 | 50.9 | 1.18e+04 | -7.43 | 1 |
| mendung | 0/0 | saputra | 0.0363 | 0.0326 | 0.0603 | 2.29e+03 | -4.5 | 0 |
| mendung | 0/0 | bias | 0.371 | 0.329 | 0.587 | 2.29e+03 | -4.5 | 4.86e-05 |
| mendung | 3/2 | astro | 2.4 | 2.38 | 2.88 | 2.29e+03 | -5.09 | 0 |
| mendung | 3/2 | ldr | 35 | 33.1 | 52.3 | 1.18e+04 | -7.85 | 1 |
| mendung | 3/2 | saputra | 2.4 | 2.38 | 2.88 | 2.29e+03 | -5.09 | 0 |
| mendung | 3/2 | bias | 2.39 | 2.37 | 2.85 | 2.29e+03 | -5.09 | 4.86e-05 |
| mendung | 6/4 | astro | 4.84 | 4.8 | 5.81 | 2.29e+03 | -5.72 | 0 |
| mendung | 6/4 | ldr | 35.7 | 33.8 | 53 | 1.18e+04 | -8.31 | 1 |
| mendung | 6/4 | saputra | 4.84 | 4.8 | 5.81 | 2.29e+03 | -5.72 | 0 |
| mendung | 6/4 | bias | 4.82 | 4.78 | 5.76 | 2.29e+03 | -5.72 | 4.86e-05 |

## E1: 2026-06-21

| weather | bias | ctrl | rmse | tae | p95 | acts | gain | f_ldr |
|---|---|---|---|---|---|---|---|---|
| cerah | 0/0 | astro | 0.0381 | 0.035 | 0.059 | 1.42e+03 | 24 | 0 |
| cerah | 0/0 | ldr | 4.64 | 4.62 | 5.14 | 755 | 23.8 | 1 |
| cerah | 0/0 | saputra | 4.65 | 4.64 | 5.1 | 509 | 23.8 | 0.782 |
| cerah | 0/0 | bias | 4.01 | 4 | 4.27 | 1.42e+03 | 23.9 | 0.734 |
| cerah | 3/2 | astro | 2.7 | 2.69 | 2.92 | 1.42e+03 | 24.2 | 0 |
| cerah | 3/2 | ldr | 4.67 | 4.66 | 5.13 | 779 | 24 | 1 |
| cerah | 3/2 | saputra | 4.68 | 4.67 | 5.09 | 460 | 24 | 0.785 |
| cerah | 3/2 | bias | 4.03 | 4.02 | 4.36 | 1.45e+03 | 24.1 | 0.743 |
| cerah | 6/4 | astro | 5.44 | 5.44 | 5.88 | 1.42e+03 | 24.1 | 0 |
| cerah | 6/4 | ldr | 4.65 | 4.64 | 5.1 | 781 | 24.3 | 1 |
| cerah | 6/4 | saputra | 4.65 | 4.64 | 5.05 | 465 | 24.2 | 0.786 |
| cerah | 6/4 | bias | 4.12 | 4.12 | 4.37 | 1.46e+03 | 24.3 | 0.747 |
| sebagian | 0/0 | astro | 0.0381 | 0.035 | 0.059 | 1.42e+03 | 18.3 | 0 |
| sebagian | 0/0 | ldr | 19 | 13.2 | 43.9 | 7.51e+03 | 16.4 | 1 |
| sebagian | 0/0 | saputra | 2.56 | 2.05 | 3.69 | 1.28e+03 | 18.2 | 0.49 |
| sebagian | 0/0 | bias | 3.36 | 3.35 | 3.75 | 1.48e+03 | 18.2 | 0.429 |
| sebagian | 3/2 | astro | 2.7 | 2.69 | 2.92 | 1.42e+03 | 18.3 | 0 |
| sebagian | 3/2 | ldr | 19.4 | 13.8 | 43.4 | 7.56e+03 | 16.1 | 1 |
| sebagian | 3/2 | saputra | 3.06 | 2.96 | 4.02 | 1.44e+03 | 18.2 | 0.492 |
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
| sebagian | 0.01 | bias | 2.22 | 2.51 | 2.29e+03 | 14.9 |
| cerah | 0.02 | saputra | 12.5 | 15.2 | 319 | 17.9 |
| cerah | 0.02 | bias | 2.4 | 2.88 | 2.29e+03 | 19.6 |
| sebagian | 0.02 | saputra | 4.37 | 8.99 | 1.29e+03 | 14.8 |
| sebagian | 0.02 | bias | 2.35 | 2.77 | 2.29e+03 | 14.9 |
