riyadh-gif/solar-tracker-cps-pens/(commit log)

2026-10-19 Simulasi dan model CPS solar tracker dua sumbu PENS
    Digital Model tervalidasi untuk solar tracker dua sumbu di PENS Surabaya
    (-7.276006, 112.794327). Panel MOS C-50-18-M 50 W, dua stepper 57HSE3.0N
    loop terbuka tanpa gearbox, empat LDR bersekat.
    Isi:
    - Kinematika dan dinamika Euler-Lagrange dua sendi, inersia dari CAD
    - Model stepper loop terbuka, kuantisasi microstep, kekakuan seri
    - Kontrol: umpan maju pvlib SPA, profil trapesium, input shaper ZVD
    - Sensor: LDR empat kuadran, dioda tunggal panel, arus sebagai sensor
    - EKF penaksir simpangan sudut sebagai pengganti enkoder
    - Angin nyata Open-Meteo 11 tahun dengan model torsi berarah
    - Simulasi Gazebo, node ROS 2, panel kontrol web
    - Dokume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
    [00_part.stl, 01_part.stl, 02_part.stl, 03_part.stl, 04_part.stl, 05_part.stl, 06_part.stl, 07_part.stl]
2026-10-19 Analyse impact of moving the steppers to closed loop
    The encoder sits on the rotor, not on the load, so the chain is
    command -(magnetic spring Th*Nr)- rotor -(shaft k)- panel. Closing the
    loop stiffens the magnetic spring toward infinity, leaving the load on
    the shaft alone: K_ef rises from 137.1 to 1600 N.m/rad on azimuth and
    from 101.7 to 317 on tilt.
    Consequences, since zeta = b / (2 sqrt(K J)) falls as K rises:
    - azimuth 4.79 -> 16.4 Hz, zeta 0.0220 -> 0.0064, overshoot 93.3 -> 98.0 %
    - tilt 6.89 -> 12.2 Hz, zeta 0.0425 -> 0.0241, overshoot 87.5 -> 92.7 %
    - decay time unchanged (depends only on J and b), so the same ringing
    duration now contains 3.4x more cycles
    - ZVD tuned for the op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
2026-10-19 Phase 1: motor 57HSE3.0N -> 57HSE1.5N, still open loop
    Holding torque drops 3.0 -> 1.5 N.m. Deliberately landed on its own,
    before the closed-loop change, because the two move the system in
    opposite directions and mixing them makes the results unreadable.
    Open-loop series stiffness K = 1/(1/(Th*Nr) + 1/k):
    azimuth 137.14 -> 71.64 N.m/rad, f_n 4.79 -> 3.46 Hz, zeta 0.0220 -> 0.0304
    tilt 101.82 -> 60.65 N.m/rad, f_n 6.89 -> 5.32 Hz, zeta 0.0425 -> 0.0551
    So on the open-loop baseline a weaker motor makes the system softer and
    BETTER damped. The closed-loop change in the next phases does the
    opposite.
    build_model.py carried a hardcoded effort="3" on the elevation joint
    that was not d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
    [solar_tracker.urdf, solar_tracker_stepper.urdf]
2026-10-19 Phase 2: introduce driver gain Kp structurally, still Kp=0
    Behaviour-preserving refactor. Kp=0 reproduces every open-loop number
    exactly, so open loop stays selectable for the thesis before/after
    comparison with no flag and no second code path.
    Two shared primitives in dinamika/dyn_model.py:
    Axis.K_ser() small-signal stiffness felt by the load:
    1/(1/(Th*Nr + Kp) + 1/k)
    rotor_offset(ax,t) rotor deflection holding torque t:
    sat(Th*sin(Nr*e) + Kp*e, +-Th) = t
    Kp=0 uses the old closed form asin(t/Th)/Nr
    The series-stiffness formula was duplicated in FIVE places, not the
    three first identified. The two extra copies we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
    [stepper_node.py, sun_command_node.py, wind_node.py]
2026-10-19 Phase 3: closed-loop mechanism in place, Kp still 0 pending datasheet
    The flip to closed loop is now a one-constant change: set Kp=KP_NOM in
    AXES and the Gazebo gains, the ZVD shaper, wind_node and osilasi_energi
    all follow through Axis.K_ser(). Verified the shaper retunes itself:
    azimuth ZVD taps moved from 14 to 3 samples when Kp was switched on.
    Kp is deliberately left at 0 for now. Two findings stopped me from
    picking a value:
    1. Kp -> infinity (rotor locked) is NOT a conservative bound, which is
    what I previously assumed and published. Driver torque is still
    capped at Th, so the small-signal stiffness only exists while rotor
    deflection stays under Th/(Th*Nr + Kp). At Kp=1e9 t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
    [wind_node.py]
2026-10-19 Phase 4: Gazebo validation at Th=1.5, still open loop
    Four recordings, /joint_states at 1000 Hz throughout. Results in
    solar_tracker/validasi_th1.5_results.md.
    Validated:
    - Python model and Gazebo agree within 0.05 percentage points on
    azimuth shaper comparison, at both 5 and 90 degree steps.
    ZVD takes azimuth 90 deg overshoot from 40.62 % to 0.00 %.
    - Gravity deflection measured -0.244 deg against 0.261 predicted from
    Mg(0)/K_el = 0.276/60.65. The Th -> K_ser -> deflection chain is
    correct end to end at the new motor torque.
    - The elevation raw-step mismatch (8.01 vs 59.66) is the known
    velocity="1" perfect-brake artefact, previously recorded as 5.98 vs
    66.03. Not a regression;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
2026-10-21 Rebuild URDF from the new design meshes
    The vendor export in desainbaru/ is unusable: one link, zero joints,
    project named "(Unsaved)". build_model_v2.py reconstructs the kinematic
    chain from its 43 STL meshes instead. check_urdf parses it:
    world -> base_link -> azimuth_link -> elevation_link.
    CAD frame has Z pointing DOWN (panel at cz=-325, LDR lenses at cz=-360,
    ground frame at cz=0), so a 180 degree rotation about X is applied.
    Axes derived from geometry, not guessed:
    azimuth motor 57HSE_3.0N_1 vertical at (0,0), long axis Z
    tilt shaft as_8mm (194 mm) along X at y=0, z=-292.1, i.e. along
    the long rails, matching the existing convention
    GEAR REDUCTION, the biggest ch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
    [solar_tracker_v2.urdf]
2026-10-21 Integrate gear ratio into dyn_model, add v2 world and launch
    dyn_model: Axis gains an N field (gear reduction motor:load, default
    1.0) plus load-referred properties Th_L, Nr_L, Kp_L, Jm_L and
    step_beban. K_ser, freqs_hz, rotor_offset and integrate now all work in
    load-referred terms, so the reduction flows through every consumer the
    same way Kp does. N=1 reproduces the direct-drive numbers exactly:
    azimuth K=71.64 f=3.46 Hz, tilt K=60.65 f=5.32 Hz, all selftests pass.
    AXES_V2 added for the new design, kept separate from AXES so the old
    results stay comparable:
    tilt N=5.25 K_ser=274.85 Th_L=7.875 N.m f_n=10.89 Hz
    microstep at load 0.0214 deg, gravity 11.2 % of Th_L
    azim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
    [solar_tracker_v2.urdf, world_v2.sdf]
2026-10-21 Migrate all nodes to v2 and delete v1
    v1 is gone: solar_tracker/ removed entirely. Sun, sensor, EKF, wind,
    stepper, both control panels and all four recorders now live in
    solar_tracker_v2/. They needed no path edits because every one of them
    resolves ROOT as parent.parent, which is still the project root.
    dyn_model.AXES IS now the new design, so every node that reads D.AXES
    picks it up with no edit. The old direct-drive values are archived as
    AXES_V1 for comparison; nothing uses them.
    tilt N=5.25 k=163.8 K_ser=151.77 Th_L=7.875 N.m f_n=8.09 Hz
    azimuth N=1.00 k=1600 K_ser=71.64 Th_L=1.500 N.m f_n=3.46 Hz
    k on tilt corrected 317 -> 163.8: the as_8mm shaft measures 194 mm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
    [azimuth_link.stl, base.stl, elevation_link.stl, solar_tracker.urdf, solar_tracker_stepper.urdf, solar_tracker_v2.urdf, world.sdf, world_stepper.sdf]
2026-10-21 Correct gear ratio to 5.00:1, measured on the rig
    User counted 5 pinion turns per 1 turn of the large gear, and measured
    outer diameters 22 and 88 mm. That is the authoritative measurement and
    it overrides my CAD-derived figure.
    My 5.25:1 was wrong. It came from fitting module 2 with z=8/42 to the
    mesh centre distance, and it predicted a 20 mm pinion against the 22 mm
    actually fitted.
    The measurements reconcile as outer diameters: OD = m(z+2) with
    z2/z1 = 5 gives (5*z1+2)/(z1+2) = 88/22 = 4, so z1=6, z2=30, module
    2.75. Check: 2.75*8 = 22 and 2.75*32 = 88, both exact. Pitch diameters
    16.5 and 82.5, whose ratio is exactly 5. Centre distance 49.5 mm
    against 50.2 measured in CAD.
    Also wrong: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
    [solar_tracker_v2.urdf]
2026-10-21 Enable closed loop (Kp) now that the driver is confirmed closed-loop
    User confirmed the steppers are closed loop, so AXES now carries
    Kp=KP_NOM=300 on both axes.
    The key result is that the unknown driver gain barely matters on the
    geared axis, and matters enormously on the direct one:
    tilt f_n 8.06 .. 8.41 Hz across Kp = 0 .. infinity, spread 4.3 %
    azimuth f_n 3.46 .. 16.36 Hz across the same range, spread 373 %
    The 5:1 reduction raises the load-referred magnetic spring past
    1875 N.m/rad against a 163.8 shaft, so the SHAFT sets the stiffness and
    the driver gain is almost irrelevant there. Azimuth is direct drive
    against a 1600 shaft, so Kp dominates. The pending datasheet therefo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
    [solar_tracker_v2.urdf]
2026-10-21 Park the panel flat when it rains, driven by real precipitation data
    Agreed policy: the tracker goes flat during rain. Implemented from real
    data rather than an invented weather model, matching how wind was done.
    Data: Open-Meteo Archive API, same endpoint as the wind set, hourly
    precipitation, rain and relative humidity for the PENS site.
    102,984 hours, 2015-01-01 to 2026-09-30, identical span to the wind
    file. 1792 mm/year, which is realistic for Surabaya, and the monsoon
    shows clearly: 43.7 % of daylight hours wet in February against 2.2 %
    in August.
    New cuaca/hujan.py: impor, muat, hari, mm_pada, parkir, ringkas.
    sun_command_node gains parkir_hujan (default true), hujan_ambang
    (0.2 mm/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
    [hujan_pens_2015-2026.csv]
2026-10-21 Add wet-glass optics and rain cooling to the electrical model
    Both effects turned out to work against my earlier claims, so the
    numbers here correct two things I said.
    WET GLASS IS NOT INHERENTLY LOSSY. A uniform water film REDUCES
    reflection, because water's refractive index (1.333) sits between air
    (1.0) and glass (1.52), so it acts as an index-matching layer. Fresnel
    at normal incidence: dry reflects 4.26 %, wet 2.46 %, so transmission
    RISES 1.88 %. That part is derived, not assumed. The loss during rain
    comes from DROPLETS scattering and shadowing, which is the empirical
    term, RUGI_TETES = 0.05 with a literature range of 0.02 to 0.08.
    Net transmission factor 0.9679.
    COOLING WAS DOUBLE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
    [sensor_node.py]
2026-10-21 Add run guide for the v2 simulation
    Covers one-time venv setup, rebuilding the model from CAD meshes (which
    are gitignored, so a fresh clone must run build_model_v2.py first),
    leftover-process cleanup, the launch commands, every launch argument,
    how to read the topics, and the traps that actually cost time in this
    session.
    Verified the full command before documenting it: 18 topics, zero errors
    in the log, exactly one publisher per topic.
2026-10-21 Update the CPS paper for the new design
    Rewrites every part of sistem_cps_tracker_pens.tex that described the
    old rig. Compiles clean: 21 pages, no errors, no undefined references.
    Abstract rewritten. The hardware is now a closed-loop 57HSE1.5N with a
    rotor encoder and a 5.0:1 reduction on tilt.
    Section 5 retitled from "Motor Stepper Loop Terbuka" to "Stepper Loop
    Tertutup dengan Reduksi Gigi", with:
    - torque law gaining the driver term and saturation,
    Sat(Th sin(Nr e) + Kp e, +-Th), and the physical bound on Kp
    (linear range Th/(Th Nr + Kp); Kp -> infinity is NOT physical)
    - a new subsection deriving the gear ratio from the measured values
    - series stiffness now (Th Nr + Kp)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
2026-10-21 Make rain a live panel control instead of a launch argument
    You were right that this was badly designed. Rain was baked into the
    launch, so changing it meant relaunching the whole simulation, and the
    date lived in TWO nodes independently. That second part had already
    caused a silent bug: sensor_node kept its own date default and never saw
    the rain that sun_command_node was acting on.
    Fixed by giving rain one owner. sun_command_node decides and publishes
    /hujan/state [basah, mm/jam, mode]; sensor_node and the panel subscribe
    instead of each recomputing it. sensor_node's tanggal and hujan_auto
    parameters are gone, so the two can no longer disagree.
    parkir_hujan (bool) becomes hujan_mode with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
    [control_panel.py, control_web.py, sensor_node.py, sun_command_node.py]
2026-10-21 Re-measure step and shaper response for the geared closed-loop config
    Both reruns done, and they resolve the two things I had flagged as
    undiagnosed. Full results in solar_tracker_v2/validasi_v2_results.md.
    ZVD validated across the whole range:
    az 1 deg 85.61 % raw -> 2.16 % with ZVD
    az 5 deg 58.40 % -> 0.80 %
    az 90 deg 3.21 % -> 0.02 %
    el 20 deg 5.15 % -> 0.11 %
    Every profiled strategy agrees with the Python model to about one
    percentage point.
    FIRST FINDING RESOLVED: the raw-step mismatch is the URDF velocity="1"
    rad/s limit, not a dynamics error. Saturated acceleration a = Th_L/J
    gives peak speed sqrt(2*a*theta):
    azimuth a = 9.91 1 deg 0.59 FREE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
    [rec_step.py]
2026-10-21 Add Raspberry Pi 5 deployment: hardware sensor node and bootstrap
    Two deliverables for putting the controller on the Pi.
    sensor_hw_node.py replaces sensor_node.py on the real rig. It is the
    Digital Model -> Digital Shadow bridge the paper describes in section
    13: it publishes /tracker/diag in the SAME format, so ekf_node, the web
    panel and everything downstream run unchanged. Verified end to end in
    mock mode: ekf_node consumed it without modification and reported a
    healthy NIS with the offset estimate running.
    Sensors chosen, with the reason:
    ADS1115 at 0x48 four LDRs, exactly four channels, 16 bit, I2C
    INA226 at 0x40 panel current and voltage, 0.01 ohm shunt
    INA226 over INA219 beca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
    [sensor_hw_node.py]
2026-10-21 Add offline path to get the code onto the Pi via the boot partition
    Answers the SD-card question properly. Two things I had missed:
    First, writing to the card now is pointless: we agreed to reflash it
    with Ubuntu Server 24.04, which destroys whatever is on the ext4
    partition. The correct order is flash first, then load the code.
    Second, the boot partition IS writable from Windows without admin. It
    is FAT32 and gets a drive letter; only the ext4 root is unreadable.
    Linux mounts that same partition at /boot/firmware, so a file dropped
    there from Windows is visible to the Pi immediately. That gives a route
    that needs neither admin here nor network on the Pi.
    buat_bekal_raspi.sh packs only wh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
2026-10-23 Add the motor driver node and prove all three Pi functions with dummy input
    Function 1 (drive both motors) had no code at all. motor_node.py is now the
    only node that touches GPIO: lgpio on gpiochip4, since RPi.GPIO does not work
    on a Pi 5. It converts load angles to motor steps through the gear ratio read
    from dyn_model.AXES, so tilt needs five times as many steps per degree as
    azimuth.
    It deliberately has no motion profile. sun_command_node already applies the
    trapezoidal profile and the ZVD shaper before publishing, exactly as in
    Gazebo, where the actuator only follows that command under torque saturation.
    A second profile here would re-filter an already shaped command and undo the
    valid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
    [motor_node.py, sensor_hw_node.py]
2026-10-23 Add an operating guide for the Pi as raspi/petunjuk.txt
    Plain text so it is readable over a bare SSH session with no tooling. Lives in
    the repo and is symlinked at /home/proyekssf/petunjuk.txt so it is the first
    thing visible on login.
    It covers the run commands, why uji3.sh stays silent for the first 20 seconds
    (pvlib loads a full day of sun positions before the first command), where the
    logs are, the pin map that is still an assumption, and how to switch off mock
    mode once the sensors are wired.
    It also records the traps that cost real debugging time: /sun/state is a
    Float64MultiArray so a String subscription silently never fires; ros2 topic
    echo --field data wraps JSON as YAML and break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
